microhobbyist/6309-Unleashed-2.0/README.md

# 6309 Unleashed 2.0
 New and upgraded 6309 build - with NITROS-9 in mind!
