microhobbyist/6309-Unleashed-2.0/(list of files, drawings)

Other design files:
Episode3/Logisim/ShadowLockCircuit.circ
