microhobbyist/6309-Unleashed-2.0/Episode5 - CPU card/Episode5 - CPU card.kicad_pcb

## KiCad design Episode5 - CPU card/Episode5 - CPU card.kicad_pcb (2026-03-01)

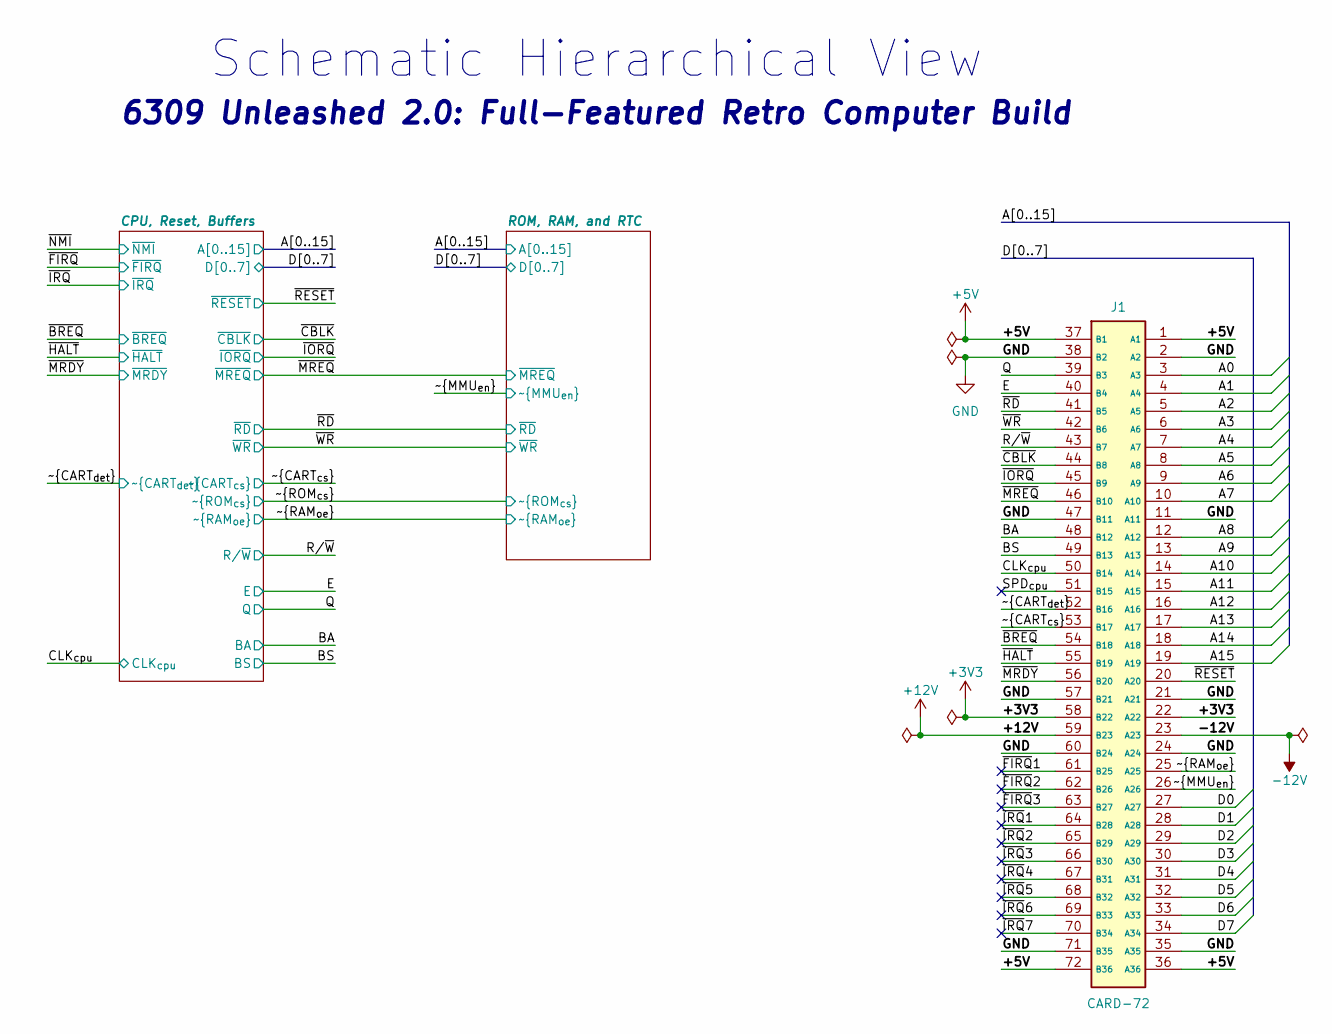
[picture p1: schematic Episode5 - CPU card.kicad_sch, The CPU Card]

Parts:
J1: CARD-72; 72-pin Card Edge PCB; Mouser Part Number 571-5530843-8

Connections:
+3V3: J1.22 (A22), J1.58 (B22)
+5V: J1.1 (A1), J1.36 (A36), J1.37 (B1), J1.72 (B36); also elsewhere on the board
+12V: J1.59 (B23)
-12V: J1.23 (A23)
/A0: J1.3 (A3); also elsewhere on the board
/A1: J1.4 (A4); also elsewhere on the board
/A2: J1.5 (A5); also elsewhere on the board
/A3: J1.6 (A6); also elsewhere on the board
/A4: J1.7 (A7); also elsewhere on the board
/A5: J1.8 (A8); also elsewhere on the board
/A6: J1.9 (A9); also elsewhere on the board
/A7: J1.10 (A10); also elsewhere on the board
/A8: J1.12 (A12); also elsewhere on the board
/A9: J1.13 (A13); also elsewhere on the board
/A10: J1.14 (A14); also elsewhere on the board
/A11: J1.15 (A15); also elsewhere on the board
/A12: J1.16 (A16); also elsewhere on the board
/A13: J1.17 (A17); also elsewhere on the board
/A14: J1.18 (A18); also elsewhere on the board
/A15: J1.19 (A19); also elsewhere on the board
/BA: J1.48 (B12); also elsewhere on the board
/BS: J1.49 (B13); also elsewhere on the board
/CLK_{cpu}: J1.50 (B14); also elsewhere on the board
/D0: J1.27 (A27); also elsewhere on the board
/D1: J1.28 (A28); also elsewhere on the board
/D2: J1.29 (A29); also elsewhere on the board
/D3: J1.30 (A30); also elsewhere on the board
/D4: J1.31 (A31); also elsewhere on the board
/D5: J1.32 (A32); also elsewhere on the board
/D6: J1.33 (A33); also elsewhere on the board
/D7: J1.34 (A34); also elsewhere on the board
/E: J1.40 (B4); also elsewhere on the board
/Q: J1.39 (B3); also elsewhere on the board
/R/~W: J1.43 (B7); also elsewhere on the board
/SPD_{cpu}: J1.51 (B15)
/~BREQ: J1.54 (B18); also elsewhere on the board
/~CART_{cs}: J1.53 (B17); also elsewhere on the board
/~CART_{det}: J1.52 (B16); also elsewhere on the board
/~CBLK: J1.44 (B8); also elsewhere on the board
/~FIRQ1: J1.61 (B25)
/~FIRQ2: J1.62 (B26)
/~FIRQ3: J1.63 (B27)
/~HALT: J1.55 (B19); also elsewhere on the board
/~IORQ: J1.45 (B9); also elsewhere on the board
/~IRQ1: J1.64 (B28)
/~IRQ2: J1.65 (B29)
/~IRQ3: J1.66 (B30)
/~IRQ4: J1.67 (B31)
/~IRQ5: J1.68 (B32)
/~IRQ6: J1.69 (B33)
/~IRQ7: J1.70 (B34)
/~MMU_{en}: J1.26 (A26); also elsewhere on the board
/~MRDY: J1.56 (B20); also elsewhere on the board
/~MREQ: J1.46 (B10); also elsewhere on the board
/~RAM_{oe}: J1.25 (A25); also elsewhere on the board
/~RD: J1.41 (B5); also elsewhere on the board
/~RESET: J1.20 (A20); also elsewhere on the board
/~WR: J1.42 (B6); also elsewhere on the board
GND: J1.2 (A2), J1.11 (A11), J1.21 (A21), J1.24 (A24), J1.35 (A35), J1.38 (B2), J1.47 (B11), J1.57 (B21), J1.60 (B24), J1.71 (B35); also elsewhere on the board

Notes on the sheet:
6309 Unleashed 2.0: Full-Featured Retro Computer Build
Schematic Hierarchical View

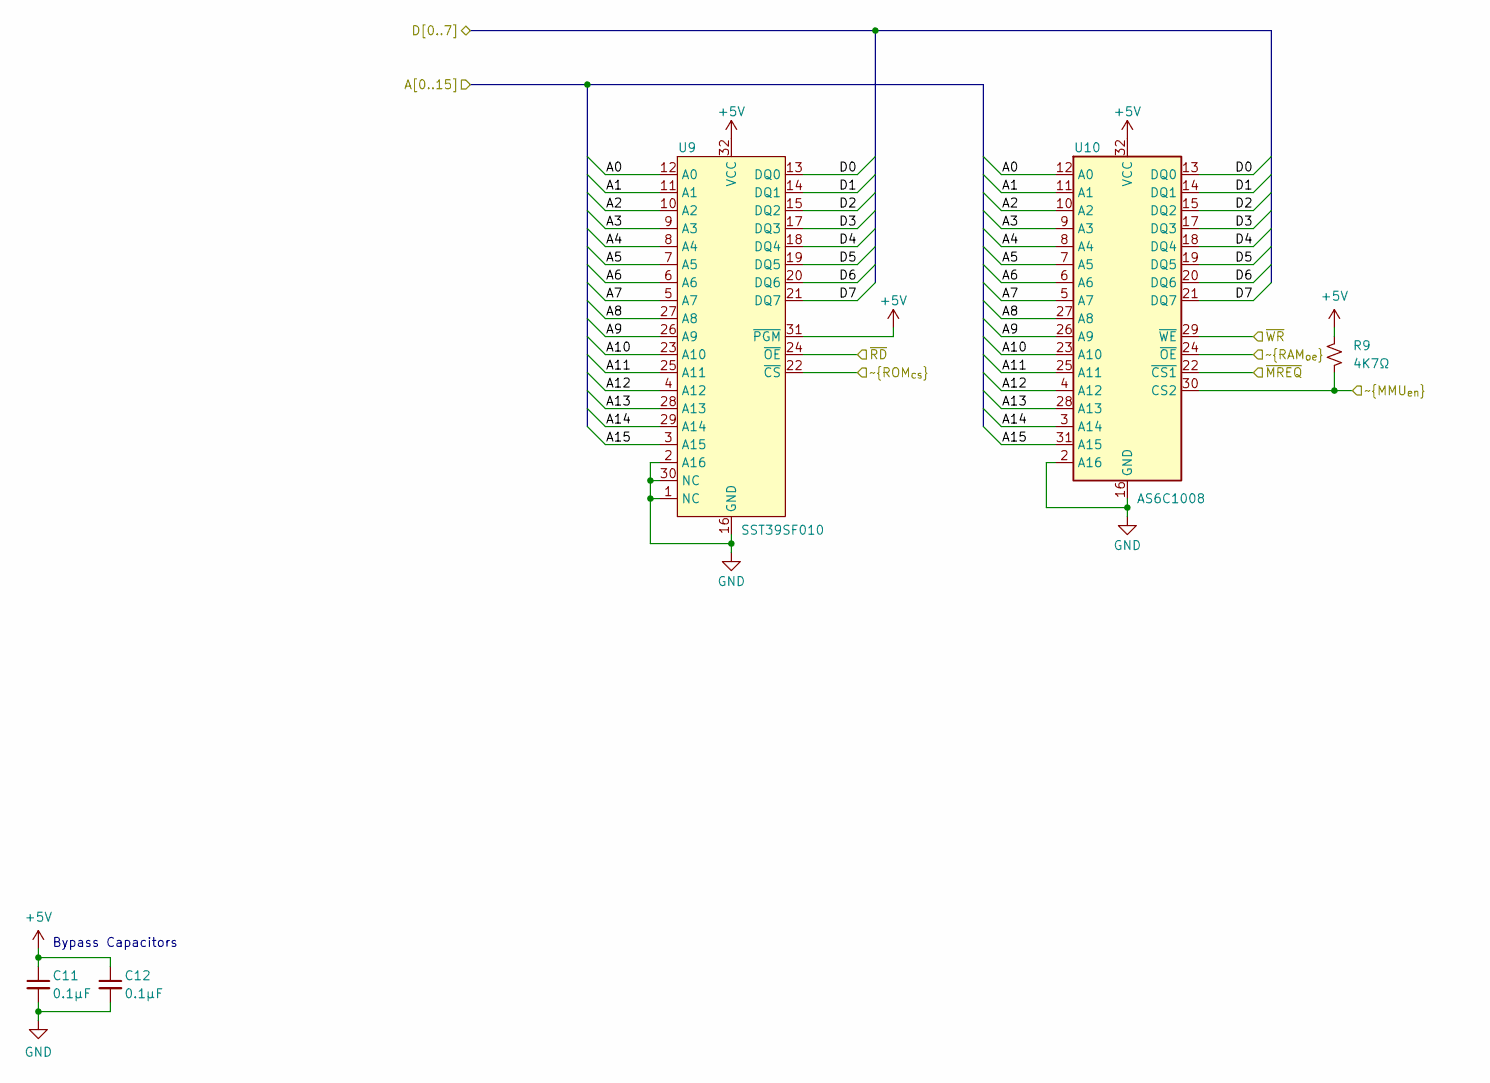
[picture p2: schematic ROMRAM.kicad_sch, Flash ROM, SRAM, and RTC]

Parts:
C11, C12: 0.1µF; C_Disc_D3.0mm_W1.6mm_P2.50mm
R9: 4K7Ω; R_Axial_DIN0207_L6.3mm_D2.5mm_P10.16mm_Horizontal
U9: SST39SF010; DIP_Socket-32_W11.9mm_W12.7mm_W15.24mm_W17.78mm_W18.5mm_3M_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
U10: AS6C1008; DIP-32_W15.24mm_Socket

Connections:
+5V: C11.1, C12.1, R9.2, U9.31 (~PGM), U9.32 (VCC), U10.32 (VCC); also elsewhere on the board
/A0: U9.12 (A0), U10.12 (A0); also elsewhere on the board
/A1: U9.11 (A1), U10.11 (A1); also elsewhere on the board
/A2: U9.10 (A2), U10.10 (A2); also elsewhere on the board
/A3: U9.9 (A3), U10.9 (A3); also elsewhere on the board
/A4: U9.8 (A4), U10.8 (A4); also elsewhere on the board
/A5: U9.7 (A5), U10.7 (A5); also elsewhere on the board
/A6: U9.6 (A6), U10.6 (A6); also elsewhere on the board
/A7: U9.5 (A7), U10.5 (A7); also elsewhere on the board
/A8: U9.27 (A8), U10.27 (A8); also elsewhere on the board
/A9: U9.26 (A9), U10.26 (A9); also elsewhere on the board
/A10: U9.23 (A10), U10.23 (A10); also elsewhere on the board
/A11: U9.25 (A11), U10.25 (A11); also elsewhere on the board
/A12: U9.4 (A12), U10.4 (A12); also elsewhere on the board
/A13: U9.28 (A13), U10.28 (A13); also elsewhere on the board
/A14: U9.29 (A14), U10.3 (A14); also elsewhere on the board
/A15: U9.3 (A15), U10.31 (A15); also elsewhere on the board
/D0: U9.13 (DQ0), U10.13 (DQ0); also elsewhere on the board
/D1: U9.14 (DQ1), U10.14 (DQ1); also elsewhere on the board
/D2: U9.15 (DQ2), U10.15 (DQ2); also elsewhere on the board
/D3: U9.17 (DQ3), U10.17 (DQ3); also elsewhere on the board
/D4: U9.18 (DQ4), U10.18 (DQ4); also elsewhere on the board
/D5: U9.19 (DQ5), U10.19 (DQ5); also elsewhere on the board
/D6: U9.20 (DQ6), U10.20 (DQ6); also elsewhere on the board
/D7: U9.21 (DQ7), U10.21 (DQ7); also elsewhere on the board
/~MMU_{en}: R9.1, U10.30 (CS2); also elsewhere on the board
/~MREQ: U10.22 (~CS1); also elsewhere on the board
/~RAM_{oe}: U10.24 (~OE); also elsewhere on the board
/~RD: U9.24 (~OE); also elsewhere on the board
/~ROM_{cs}: U9.22 (~CS); also elsewhere on the board
/~WR: U10.29 (~WE); also elsewhere on the board
GND: C11.2, C12.2, U9.1 (NC), U9.2 (A16), U9.16 (GND), U9.30 (NC), U10.2 (A16), U10.16 (GND); also elsewhere on the board

Notes on the sheet:
Bypass Capacitors

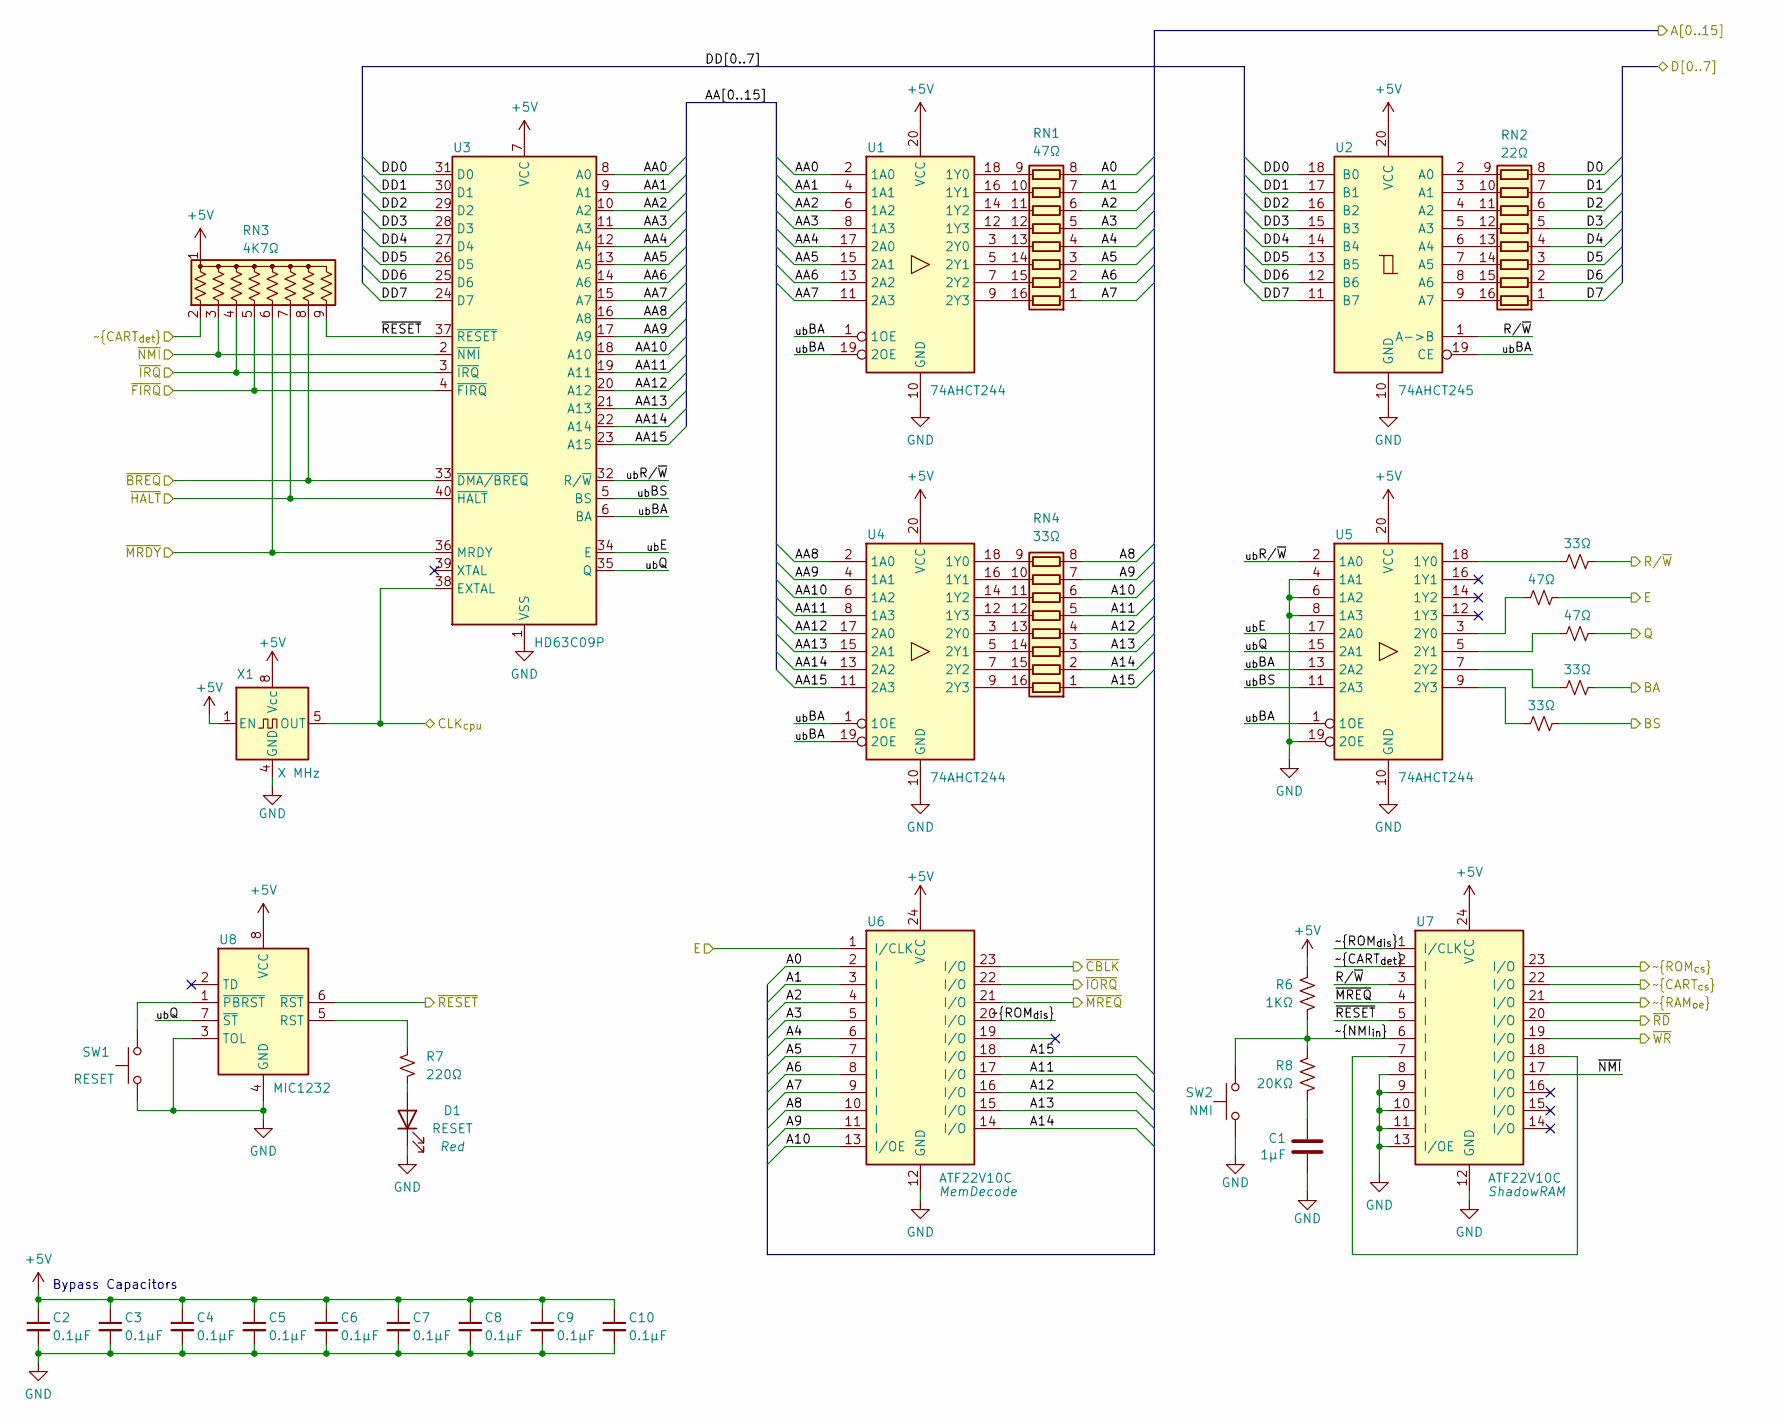
[picture p3: schematic CPU_RESET_BUFFERS.kicad_sch, CPU, Clock, Reset, and Buffers]

Parts:
C1: 1µF; C_Disc_D3.0mm_W1.6mm_P2.50mm
C2, C3, C4, C5, C6, C7, C8, C9, C10: 0.1µF; C_Disc_D3.0mm_W1.6mm_P2.50mm
D1: RESET; LED_D5.0mm
R1, R4, R5: 33Ω; R_Axial_DIN0207_L6.3mm_D2.5mm_P10.16mm_Horizontal
R2, R3: 47Ω; R_Axial_DIN0207_L6.3mm_D2.5mm_P10.16mm_Horizontal
R6: 1KΩ; R_Axial_DIN0207_L6.3mm_D2.5mm_P10.16mm_Horizontal
R7: 220Ω; R_Axial_DIN0207_L6.3mm_D2.5mm_P10.16mm_Horizontal
R8: 20KΩ; R_Axial_DIN0207_L6.3mm_D2.5mm_P10.16mm_Horizontal
RN1: 47Ω; DIP-16_W7.62mm_Socket
RN2: 22Ω; DIP-16_W7.62mm_Socket
RN3: 4K7Ω; R_Array_SIP9
RN4: 33Ω; DIP-16_W7.62mm_Socket
SW1: RESET; SW_Tactile_SKHH_Angled
SW2: NMI; SW_Tactile_SKHH_Angled
U1, U4, U5: 74AHCT244; DIP-20_W7.62mm_Socket
U2: 74AHCT245; DIP-20_W7.62mm_Socket
U3: HD63C09P; DIP-40_W15.24mm_Socket
U6, U7: ATF22V10C; DIP-24_W7.62mm_Socket
U8: MIC1232; DIP-8_W7.62mm_Socket
X1: X MHz; Oscillator_DIP-8

Connections:
+5V: C2.1, C3.1, C4.1, C5.1, C6.1, C7.1, C8.1, C9.1, C10.1, R6.1, RN3.1 (common), U1.20 (VCC), U2.20 (VCC), U3.7 (VCC), U4.20 (VCC), U5.20 (VCC), U6.24 (VCC), U7.24 (VCC), U8.8 (VCC), X1.1 (EN), X1.8 (Vcc); also elsewhere on the board
/A0: RN1.8 (R8.1), U6.2 (I); also elsewhere on the board
/A1: RN1.7 (R7.1), U6.3 (I); also elsewhere on the board
/A2: RN1.6 (R6.1), U6.4 (I); also elsewhere on the board
/A3: RN1.5 (R5.1), U6.5 (I); also elsewhere on the board
/A4: RN1.4 (R4.1), U6.6 (I); also elsewhere on the board
/A5: RN1.3 (R3.1), U6.7 (I); also elsewhere on the board
/A6: RN1.2 (R2.1), U6.8 (I); also elsewhere on the board
/A7: RN1.1 (R1.1), U6.9 (I); also elsewhere on the board
/A8: RN4.8 (R8.1), U6.10 (I); also elsewhere on the board
/A9: RN4.7 (R7.1), U6.11 (I); also elsewhere on the board
/A10: RN4.6 (R6.1), U6.13 (I/OE); also elsewhere on the board
/A11: RN4.5 (R5.1), U6.17 (I/O); also elsewhere on the board
/A12: RN4.4 (R4.1), U6.16 (I/O); also elsewhere on the board
/A13: RN4.3 (R3.1), U6.15 (I/O); also elsewhere on the board
/A14: RN4.2 (R2.1), U6.14 (I/O); also elsewhere on the board
/A15: RN4.1 (R1.1), U6.18 (I/O); also elsewhere on the board
/BA: R4.2; also elsewhere on the board
/BS: R5.2; also elsewhere on the board
/CLK_{cpu}: U3.38 (EXTAL), X1.5 (OUT); also elsewhere on the board
/CPU, Reset, Buffers/AA0: U1.2 (1A0), U3.8 (A0)
/CPU, Reset, Buffers/AA1: U1.4 (1A1), U3.9 (A1)
/CPU, Reset, Buffers/AA2: U1.6 (1A2), U3.10 (A2)
/CPU, Reset, Buffers/AA3: U1.8 (1A3), U3.11 (A3)
/CPU, Reset, Buffers/AA4: U1.17 (2A0), U3.12 (A4)
/CPU, Reset, Buffers/AA5: U1.15 (2A1), U3.13 (A5)
/CPU, Reset, Buffers/AA6: U1.13 (2A2), U3.14 (A6)
/CPU, Reset, Buffers/AA7: U1.11 (2A3), U3.15 (A7)
/CPU, Reset, Buffers/AA8: U3.16 (A8), U4.2 (1A0)
/CPU, Reset, Buffers/AA9: U3.17 (A9), U4.4 (1A1)
/CPU, Reset, Buffers/AA10: U3.18 (A10), U4.6 (1A2)
/CPU, Reset, Buffers/AA11: U3.19 (A11), U4.8 (1A3)
/CPU, Reset, Buffers/AA12: U3.20 (A12), U4.17 (2A0)
/CPU, Reset, Buffers/AA13: U3.21 (A13), U4.15 (2A1)
/CPU, Reset, Buffers/AA14: U3.22 (A14), U4.13 (2A2)
/CPU, Reset, Buffers/AA15: U3.23 (A15), U4.11 (2A3)
/CPU, Reset, Buffers/DD0: U2.18 (B0), U3.31 (D0)
/CPU, Reset, Buffers/DD1: U2.17 (B1), U3.30 (D1)
/CPU, Reset, Buffers/DD2: U2.16 (B2), U3.29 (D2)
/CPU, Reset, Buffers/DD3: U2.15 (B3), U3.28 (D3)
/CPU, Reset, Buffers/DD4: U2.14 (B4), U3.27 (D4)
/CPU, Reset, Buffers/DD5: U2.13 (B5), U3.26 (D5)
/CPU, Reset, Buffers/DD6: U2.12 (B6), U3.25 (D6)
/CPU, Reset, Buffers/DD7: U2.11 (B7), U3.24 (D7)
/CPU, Reset, Buffers/_{ub}BA: U1.1 (1OE), U1.19 (2OE), U2.19 (CE), U3.6 (BA), U4.1 (1OE), U4.19 (2OE), U5.1 (1OE), U5.13 (2A2)
/CPU, Reset, Buffers/_{ub}BS: U3.5 (BS), U5.11 (2A3)
/CPU, Reset, Buffers/_{ub}E: U3.34 (E), U5.17 (2A0)
/CPU, Reset, Buffers/_{ub}Q: U3.35 (Q), U5.15 (2A1), U8.7 (~ST)
/CPU, Reset, Buffers/_{ub}R/~W: U3.32 (R/~W), U5.2 (1A0)
/CPU, Reset, Buffers/~NMI_{in}: R6.2, R8.1, SW2.2, U7.6 (I)
/CPU, Reset, Buffers/~ROM_{dis}: U6.20 (I/O), U7.1 (I/CLK)
/D0: RN2.8 (R8.1); also elsewhere on the board
/D1: RN2.7 (R7.1); also elsewhere on the board
/D2: RN2.6 (R6.1); also elsewhere on the board
/D3: RN2.5 (R5.1); also elsewhere on the board
/D4: RN2.4 (R4.1); also elsewhere on the board
/D5: RN2.3 (R3.1); also elsewhere on the board
/D6: RN2.2 (R2.1); also elsewhere on the board
/D7: RN2.1 (R1.1); also elsewhere on the board
/E: R2.2, U6.1 (I/CLK); also elsewhere on the board
/Q: R3.2; also elsewhere on the board
/R/~W: R1.2, U2.1 (A->B), U7.3 (I); also elsewhere on the board
/~BREQ: RN3.8 (R7), U3.33 (~DMA/BREQ); also elsewhere on the board
/~CART_{cs}: U7.22 (I/O); also elsewhere on the board
/~CART_{det}: RN3.2 (R1), U7.2 (I); also elsewhere on the board
/~CBLK: U6.23 (I/O); also elsewhere on the board
/~FIRQ: RN3.5 (R4), U3.4 (~FIRQ)
/~HALT: RN3.7 (R6), U3.40 (~HALT); also elsewhere on the board
/~IORQ: U6.22 (I/O); also elsewhere on the board
/~IRQ: RN3.4 (R3), U3.3 (~IRQ)
/~MRDY: RN3.6 (R5), U3.36 (MRDY); also elsewhere on the board
/~MREQ: U6.21 (I/O), U7.4 (I); also elsewhere on the board
/~NMI: RN3.3 (R2), U3.2 (~NMI), U7.17 (I/O)
/~RAM_{oe}: U7.21 (I/O); also elsewhere on the board
/~RD: U7.20 (I/O); also elsewhere on the board
/~RESET: RN3.9 (R8), U3.37 (~RESET), U7.5 (I), U8.6 (~RST); also elsewhere on the board
/~ROM_{cs}: U7.23 (I/O); also elsewhere on the board
/~WR: U7.19 (I/O); also elsewhere on the board
GND: C1.2, C2.2, C3.2, C4.2, C5.2, C6.2, C7.2, C8.2, C9.2, C10.2, D1.1 (K), SW1.1, SW2.1, U1.10 (GND), U2.10 (GND), U3.1 (VSS), U4.10 (GND), U5.4 (1A1), U5.6 (1A2), U5.8 (1A3), U5.10 (GND), U5.19 (2OE), U6.12 (GND), U7.8 (I), U7.9 (I), U7.10 (I), U7.11 (I), U7.12 (GND), U7.13 (I/OE), U8.3 (TOL), U8.4 (GND), X1.4 (GND); also elsewhere on the board
unnamed: C1.1, R8.2
unnamed: D1.2 (A), R7.1
unnamed: RN1.16 (R1.2), U1.9 (2Y3)
unnamed: RN1.15 (R2.2), U1.7 (2Y2)
unnamed: RN1.14 (R3.2), U1.5 (2Y1)
unnamed: RN1.13 (R4.2), U1.3 (2Y0)
unnamed: RN1.12 (R5.2), U1.12 (1Y3)
unnamed: RN1.11 (R6.2), U1.14 (1Y2)
unnamed: RN1.10 (R7.2), U1.16 (1Y1)
unnamed: RN1.9 (R8.2), U1.18 (1Y0)
unnamed: RN2.16 (R1.2), U2.9 (A7)
unnamed: RN2.15 (R2.2), U2.8 (A6)
unnamed: RN2.14 (R3.2), U2.7 (A5)
unnamed: RN2.13 (R4.2), U2.6 (A4)
unnamed: RN2.12 (R5.2), U2.5 (A3)
unnamed: RN2.11 (R6.2), U2.4 (A2)
unnamed: RN2.10 (R7.2), U2.3 (A1)
unnamed: RN2.9 (R8.2), U2.2 (A0)
unnamed: RN4.16 (R1.2), U4.9 (2Y3)
unnamed: RN4.15 (R2.2), U4.7 (2Y2)
unnamed: RN4.14 (R3.2), U4.5 (2Y1)
unnamed: RN4.13 (R4.2), U4.3 (2Y0)
unnamed: RN4.12 (R5.2), U4.12 (1Y3)
unnamed: RN4.11 (R6.2), U4.14 (1Y2)
unnamed: RN4.10 (R7.2), U4.16 (1Y1)
unnamed: RN4.9 (R8.2), U4.18 (1Y0)
unnamed: R1.1, U5.18 (1Y0)
unnamed: R2.1, U5.3 (2Y0)
unnamed: R3.1, U5.5 (2Y1)
unnamed: R4.1, U5.7 (2Y2)
unnamed: R5.1, U5.9 (2Y3)
unnamed: U7.7 (I), U7.18 (I/O)
unnamed: R7.2, U8.5 (RST)
unnamed: SW1.2, U8.1 (~PBRST)

Notes on the sheet:
Bypass Capacitors

Board: 2 copper layers, 40 parts (0 on the bottom side), 115 nets, no tracks yet.
