microhobbyist/6309-Unleashed-2.0/Episode4/Episode4.kicad_pcb

## KiCad design Episode4/Episode4.kicad_pcb (2026-02-20)

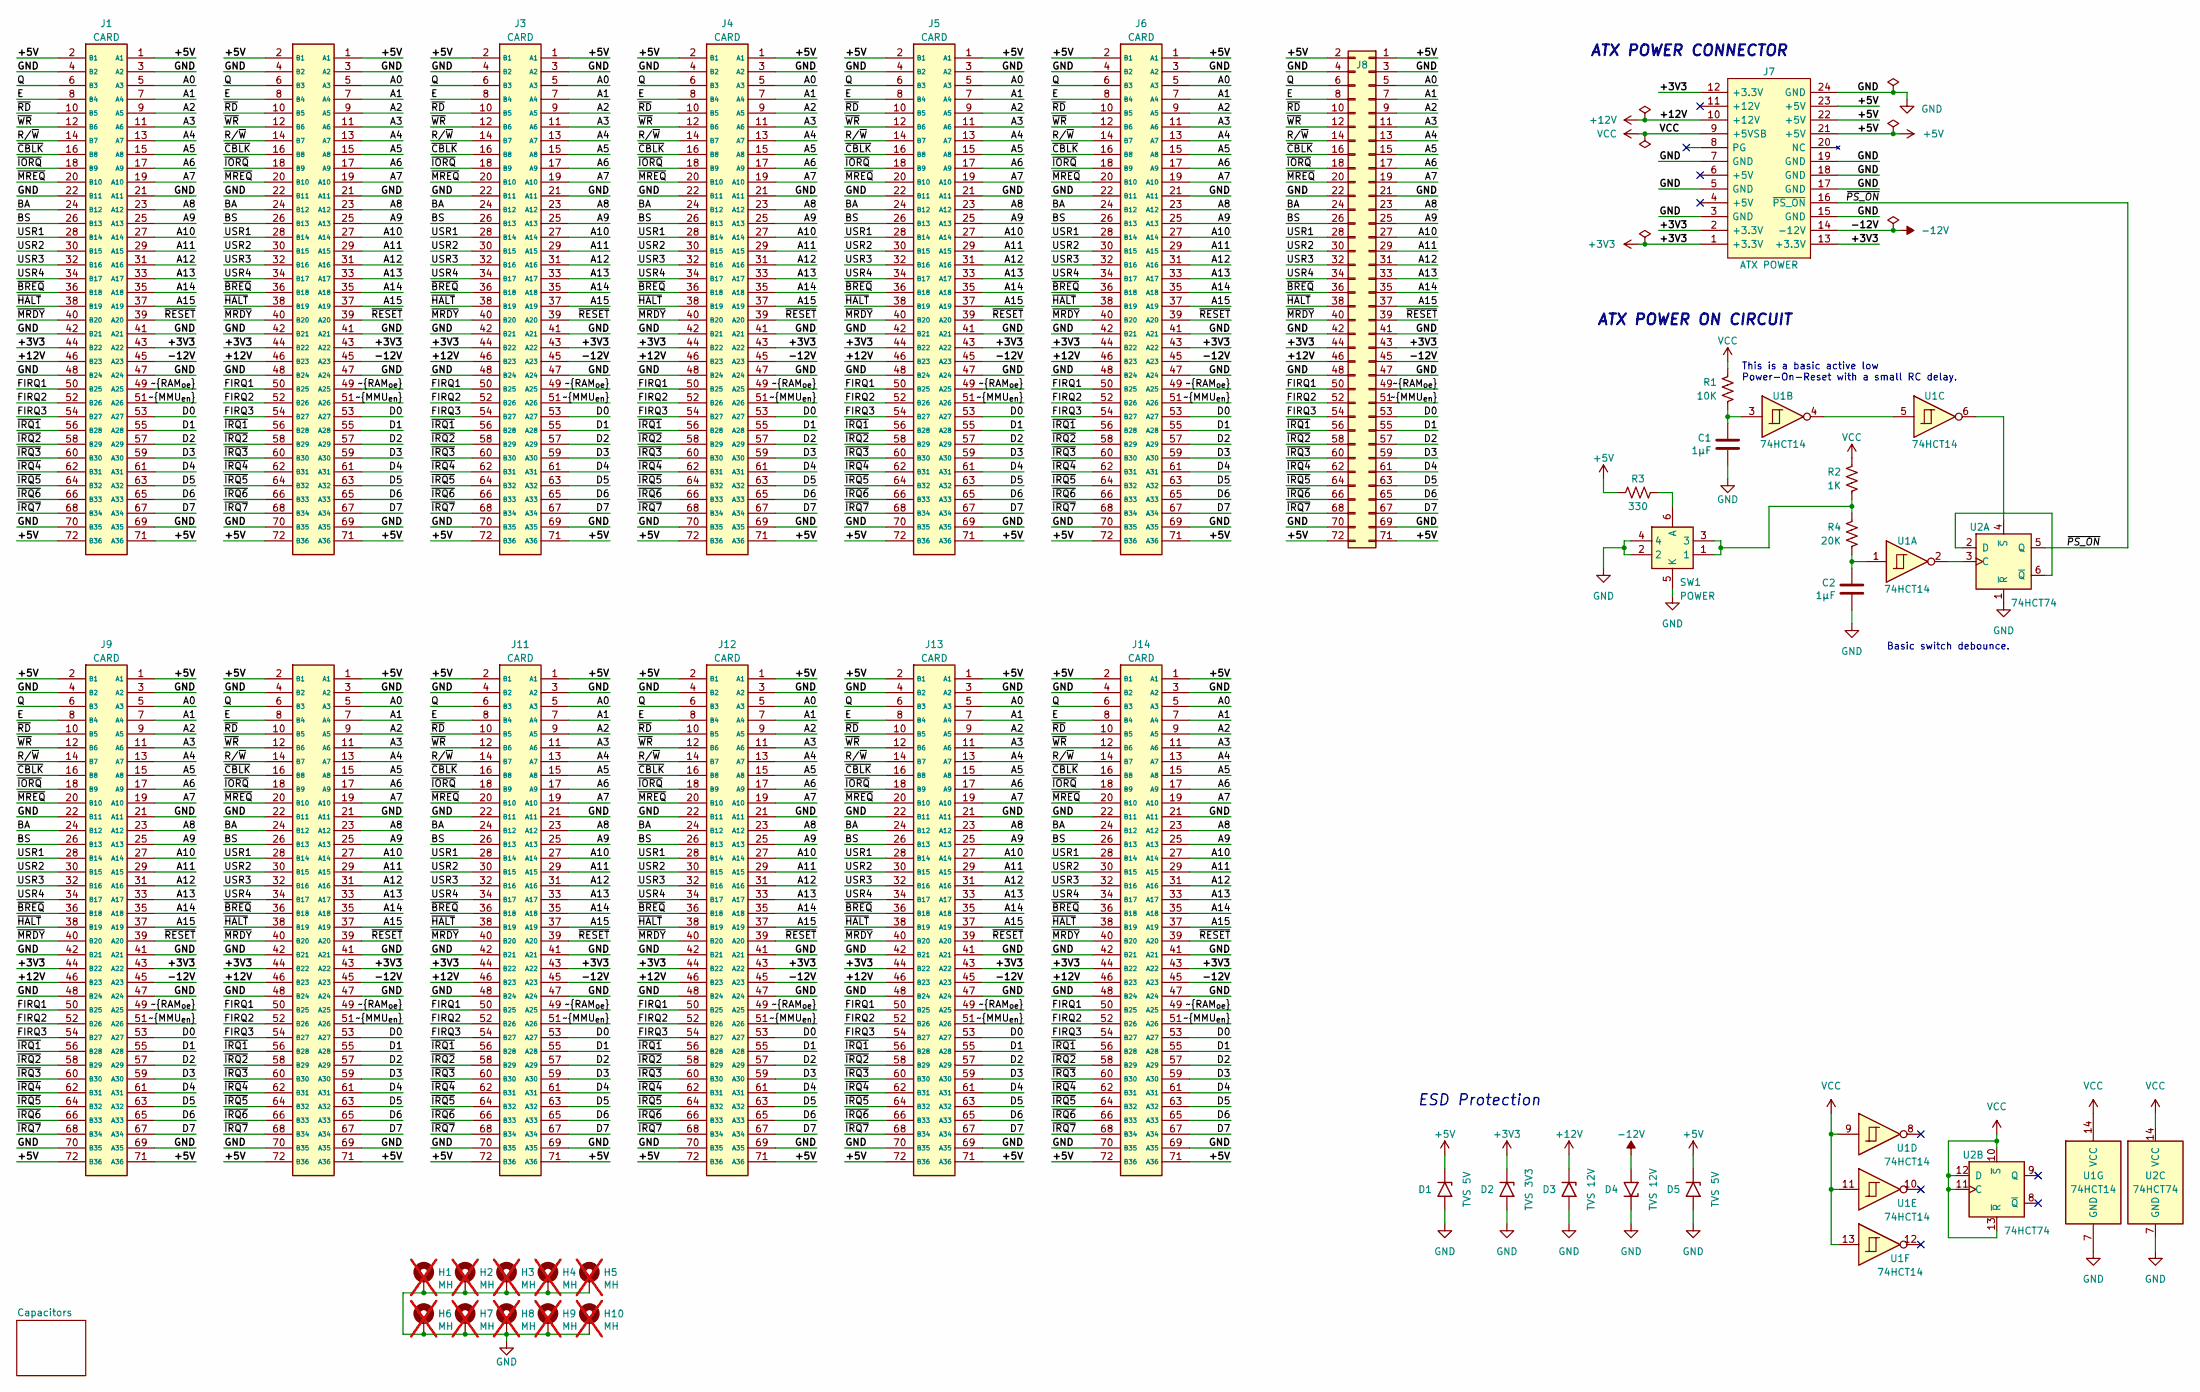
[picture p4: schematic Episode4.kicad_sch, 8-bit ISA style ATX backblane]

Parts:
C1, C2: 1µF; C_0805_2012Metric_Pad1.18x1.45mm_HandSolder; Manufacturer_Part_Number CL21B105KBFNNNG
D1, D5: TVS 5V; D_SMB; Manufacturer_Part_Number SMBJ5.0A-E3/5B
D2: TVS 3V3; D_SMB; Manufacturer_Part_Number SMBJ3V3-E3/5B
D3, D4: TVS 12V; D_SMB; Manufacturer_Part_Number SMBJ12A-E3/5B
H1, H2, H3, H4, H5, H6, H7, H8, H9, H10: MH; MountingHole_3.5mm_Pad_Via; not fitted
J1, J2, J3, J4, J5, J6, J9, J10, J11, J12, J13, J14: CARD; 72-pin CE connector; Mouser Part Number 571-5530843-8
J7: ATX POWER; ATX_PSU_CONN; Mouser Part Number 571-1-1775099-3
J8: BB Con; PinSocket_2x36_P2.54mm_Vertical; Manufacturer_Part_Number 929852-01-36-RA
R1: 10K; R_0805_2012Metric_Pad1.20x1.40mm_HandSolder; Manufacturer_Part_Number CR0805-FX-1002ELF
R2: 1K; R_0805_2012Metric_Pad1.20x1.40mm_HandSolder; Manufacturer_Part_Number CR0805-FX-1001ELF
R3: 330; R_0805_2012Metric_Pad1.20x1.40mm_HandSolder; Manufacturer_Part_Number CR0805-FX-3300ELF
R4: 20K; R_0805_2012Metric_Pad1.20x1.40mm_HandSolder; Manufacturer_Part_Number CR0805-FX-2002ELF
SW1: POWER; TS2912121G300D; Manufacturer_Part_Number TS29-1212-1-G-300-D; Mouser Part Number 179-TS2912121G300D
U1: 74HCT14; SOIC-14_3.9x8.7mm_P1.27mm; Manufacturer_Part_Number CD74HCT14M96
U2: 74HCT74; SOIC-14_3.9x8.7mm_P1.27mm; Manufacturer_Part_Number CD74HCT74M96

Connections:
+3V3: D2.1 (A1), J1.43 (A22), J1.44 (B22), J2.43 (A22), J2.44 (B22), J3.43 (A22), J3.44 (B22), J4.43 (A22), J4.44 (B22), J5.43 (A22), J5.44 (B22), J6.43 (A22), J6.44 (B22), J7.1 (+3.3V), J7.2 (+3.3V), J7.12 (+3.3V), J7.13 (+3.3V), J8.43, J8.44, J9.43 (A22), J9.44 (B22), J10.43 (A22), J10.44 (B22), J11.43 (A22), J11.44 (B22), J12.43 (A22), J12.44 (B22), J13.43 (A22), J13.44 (B22), J14.43 (A22), J14.44 (B22); also elsewhere on the board
+5V: D1.1 (A1), D5.1 (A1), J1.1 (A1), J1.2 (B1), J1.71 (A36), J1.72 (B36), J2.1 (A1), J2.2 (B1), J2.71 (A36), J2.72 (B36), J3.1 (A1), J3.2 (B1), J3.71 (A36), J3.72 (B36), J4.1 (A1), J4.2 (B1), J4.71 (A36), J4.72 (B36), J5.1 (A1), J5.2 (B1), J5.71 (A36), J5.72 (B36), J6.1 (A1), J6.2 (B1), J6.71 (A36), J6.72 (B36), J7.21 (+5V), J7.22 (+5V), J7.23 (+5V), J8.1, J8.2, J8.71, J8.72, J9.1 (A1), J9.2 (B1), J9.71 (A36), J9.72 (B36), J10.1 (A1), J10.2 (B1), J10.71 (A36), J10.72 (B36), J11.1 (A1), J11.2 (B1), J11.71 (A36), J11.72 (B36), J12.1 (A1), J12.2 (B1), J12.71 (A36), J12.72 (B36), J13.1 (A1), J13.2 (B1), J13.71 (A36), J13.72 (B36), J14.1 (A1), J14.2 (B1), J14.71 (A36), J14.72 (B36), R3.2; also elsewhere on the board
+12V: D3.1 (A1), J1.46 (B23), J2.46 (B23), J3.46 (B23), J4.46 (B23), J5.46 (B23), J6.46 (B23), J7.10 (+12V), J8.46, J9.46 (B23), J10.46 (B23), J11.46 (B23), J12.46 (B23), J13.46 (B23), J14.46 (B23); also elsewhere on the board
-12V: D4.2 (A2), J1.45 (A23), J2.45 (A23), J3.45 (A23), J4.45 (A23), J5.45 (A23), J6.45 (A23), J7.14 (-12V), J8.45, J9.45 (A23), J10.45 (A23), J11.45 (A23), J12.45 (A23), J13.45 (A23), J14.45 (A23); also elsewhere on the board
/A0: J1.5 (A3), J2.5 (A3), J3.5 (A3), J4.5 (A3), J5.5 (A3), J6.5 (A3), J8.5, J9.5 (A3), J10.5 (A3), J11.5 (A3), J12.5 (A3), J13.5 (A3), J14.5 (A3)
/A1: J1.7 (A4), J2.7 (A4), J3.7 (A4), J4.7 (A4), J5.7 (A4), J6.7 (A4), J8.7, J9.7 (A4), J10.7 (A4), J11.7 (A4), J12.7 (A4), J13.7 (A4), J14.7 (A4)
/A2: J1.9 (A5), J2.9 (A5), J3.9 (A5), J4.9 (A5), J5.9 (A5), J6.9 (A5), J8.9, J9.9 (A5), J10.9 (A5), J11.9 (A5), J12.9 (A5), J13.9 (A5), J14.9 (A5)
/A3: J1.11 (A6), J2.11 (A6), J3.11 (A6), J4.11 (A6), J5.11 (A6), J6.11 (A6), J8.11, J9.11 (A6), J10.11 (A6), J11.11 (A6), J12.11 (A6), J13.11 (A6), J14.11 (A6)
/A4: J1.13 (A7), J2.13 (A7), J3.13 (A7), J4.13 (A7), J5.13 (A7), J6.13 (A7), J8.13, J9.13 (A7), J10.13 (A7), J11.13 (A7), J12.13 (A7), J13.13 (A7), J14.13 (A7)
/A5: J1.15 (A8), J2.15 (A8), J3.15 (A8), J4.15 (A8), J5.15 (A8), J6.15 (A8), J8.15, J9.15 (A8), J10.15 (A8), J11.15 (A8), J12.15 (A8), J13.15 (A8), J14.15 (A8)
/A6: J1.17 (A9), J2.17 (A9), J3.17 (A9), J4.17 (A9), J5.17 (A9), J6.17 (A9), J8.17, J9.17 (A9), J10.17 (A9), J11.17 (A9), J12.17 (A9), J13.17 (A9), J14.17 (A9)
/A7: J1.19 (A10), J2.19 (A10), J3.19 (A10), J4.19 (A10), J5.19 (A10), J6.19 (A10), J8.19, J9.19 (A10), J10.19 (A10), J11.19 (A10), J12.19 (A10), J13.19 (A10), J14.19 (A10)
/A8: J1.23 (A12), J2.23 (A12), J3.23 (A12), J4.23 (A12), J5.23 (A12), J6.23 (A12), J8.23, J9.23 (A12), J10.23 (A12), J11.23 (A12), J12.23 (A12), J13.23 (A12), J14.23 (A12)
/A9: J1.25 (A13), J2.25 (A13), J3.25 (A13), J4.25 (A13), J5.25 (A13), J6.25 (A13), J8.25, J9.25 (A13), J10.25 (A13), J11.25 (A13), J12.25 (A13), J13.25 (A13), J14.25 (A13)
/A10: J1.27 (A14), J2.27 (A14), J3.27 (A14), J4.27 (A14), J5.27 (A14), J6.27 (A14), J8.27, J9.27 (A14), J10.27 (A14), J11.27 (A14), J12.27 (A14), J13.27 (A14), J14.27 (A14)
/A11: J1.29 (A15), J2.29 (A15), J3.29 (A15), J4.29 (A15), J5.29 (A15), J6.29 (A15), J8.29, J9.29 (A15), J10.29 (A15), J11.29 (A15), J12.29 (A15), J13.29 (A15), J14.29 (A15)
/A12: J1.31 (A16), J2.31 (A16), J3.31 (A16), J4.31 (A16), J5.31 (A16), J6.31 (A16), J8.31, J9.31 (A16), J10.31 (A16), J11.31 (A16), J12.31 (A16), J13.31 (A16), J14.31 (A16)
/A13: J1.33 (A17), J2.33 (A17), J3.33 (A17), J4.33 (A17), J5.33 (A17), J6.33 (A17), J8.33, J9.33 (A17), J10.33 (A17), J11.33 (A17), J12.33 (A17), J13.33 (A17), J14.33 (A17)
/A14: J1.35 (A18), J2.35 (A18), J3.35 (A18), J4.35 (A18), J5.35 (A18), J6.35 (A18), J8.35, J9.35 (A18), J10.35 (A18), J11.35 (A18), J12.35 (A18), J13.35 (A18), J14.35 (A18)
/A15: J1.37 (A19), J2.37 (A19), J3.37 (A19), J4.37 (A19), J5.37 (A19), J6.37 (A19), J8.37, J9.37 (A19), J10.37 (A19), J11.37 (A19), J12.37 (A19), J13.37 (A19), J14.37 (A19)
/BA: J1.24 (B12), J2.24 (B12), J3.24 (B12), J4.24 (B12), J5.24 (B12), J6.24 (B12), J8.24, J9.24 (B12), J10.24 (B12), J11.24 (B12), J12.24 (B12), J13.24 (B12), J14.24 (B12)
/BS: J1.26 (B13), J2.26 (B13), J3.26 (B13), J4.26 (B13), J5.26 (B13), J6.26 (B13), J8.26, J9.26 (B13), J10.26 (B13), J11.26 (B13), J12.26 (B13), J13.26 (B13), J14.26 (B13)
/D0: J1.53 (A27), J2.53 (A27), J3.53 (A27), J4.53 (A27), J5.53 (A27), J6.53 (A27), J8.53, J9.53 (A27), J10.53 (A27), J11.53 (A27), J12.53 (A27), J13.53 (A27), J14.53 (A27)
/D1: J1.55 (A28), J2.55 (A28), J3.55 (A28), J4.55 (A28), J5.55 (A28), J6.55 (A28), J8.55, J9.55 (A28), J10.55 (A28), J11.55 (A28), J12.55 (A28), J13.55 (A28), J14.55 (A28)
/D2: J1.57 (A29), J2.57 (A29), J3.57 (A29), J4.57 (A29), J5.57 (A29), J6.57 (A29), J8.57, J9.57 (A29), J10.57 (A29), J11.57 (A29), J12.57 (A29), J13.57 (A29), J14.57 (A29)
/D3: J1.59 (A30), J2.59 (A30), J3.59 (A30), J4.59 (A30), J5.59 (A30), J6.59 (A30), J8.59, J9.59 (A30), J10.59 (A30), J11.59 (A30), J12.59 (A30), J13.59 (A30), J14.59 (A30)
/D4: J1.61 (A31), J2.61 (A31), J3.61 (A31), J4.61 (A31), J5.61 (A31), J6.61 (A31), J8.61, J9.61 (A31), J10.61 (A31), J11.61 (A31), J12.61 (A31), J13.61 (A31), J14.61 (A31)
/D5: J1.63 (A32), J2.63 (A32), J3.63 (A32), J4.63 (A32), J5.63 (A32), J6.63 (A32), J8.63, J9.63 (A32), J10.63 (A32), J11.63 (A32), J12.63 (A32), J13.63 (A32), J14.63 (A32)
/D6: J1.65 (A33), J2.65 (A33), J3.65 (A33), J4.65 (A33), J5.65 (A33), J6.65 (A33), J8.65, J9.65 (A33), J10.65 (A33), J11.65 (A33), J12.65 (A33), J13.65 (A33), J14.65 (A33)
/D7: J1.67 (A34), J2.67 (A34), J3.67 (A34), J4.67 (A34), J5.67 (A34), J6.67 (A34), J8.67, J9.67 (A34), J10.67 (A34), J11.67 (A34), J12.67 (A34), J13.67 (A34), J14.67 (A34)
/E: J1.8 (B4), J2.8 (B4), J3.8 (B4), J4.8 (B4), J5.8 (B4), J6.8 (B4), J8.8, J9.8 (B4), J10.8 (B4), J11.8 (B4), J12.8 (B4), J13.8 (B4), J14.8 (B4)
/FIRQ1: J1.50 (B25), J2.50 (B25), J3.50 (B25), J4.50 (B25), J5.50 (B25), J6.50 (B25), J8.50, J9.50 (B25), J10.50 (B25), J11.50 (B25), J12.50 (B25), J13.50 (B25), J14.50 (B25)
/FIRQ2: J1.52 (B26), J2.52 (B26), J3.52 (B26), J4.52 (B26), J5.52 (B26), J6.52 (B26), J8.52, J9.52 (B26), J10.52 (B26), J11.52 (B26), J12.52 (B26), J13.52 (B26), J14.52 (B26)
/FIRQ3: J1.54 (B27), J2.54 (B27), J3.54 (B27), J4.54 (B27), J5.54 (B27), J6.54 (B27), J8.54, J9.54 (B27), J10.54 (B27), J11.54 (B27), J12.54 (B27), J13.54 (B27), J14.54 (B27)
/Q: J1.6 (B3), J2.6 (B3), J3.6 (B3), J4.6 (B3), J5.6 (B3), J6.6 (B3), J8.6, J9.6 (B3), J10.6 (B3), J11.6 (B3), J12.6 (B3), J13.6 (B3), J14.6 (B3)
/R/~W: J1.14 (B7), J2.14 (B7), J3.14 (B7), J4.14 (B7), J5.14 (B7), J6.14 (B7), J8.14, J9.14 (B7), J10.14 (B7), J11.14 (B7), J12.14 (B7), J13.14 (B7), J14.14 (B7)
/USR1: J1.28 (B14), J2.28 (B14), J3.28 (B14), J4.28 (B14), J5.28 (B14), J6.28 (B14), J8.28, J9.28 (B14), J10.28 (B14), J11.28 (B14), J12.28 (B14), J13.28 (B14), J14.28 (B14)
/USR2: J1.30 (B15), J2.30 (B15), J3.30 (B15), J4.30 (B15), J5.30 (B15), J6.30 (B15), J8.30, J9.30 (B15), J10.30 (B15), J11.30 (B15), J12.30 (B15), J13.30 (B15), J14.30 (B15)
/USR3: J1.32 (B16), J2.32 (B16), J3.32 (B16), J4.32 (B16), J5.32 (B16), J6.32 (B16), J8.32, J9.32 (B16), J10.32 (B16), J11.32 (B16), J12.32 (B16), J13.32 (B16), J14.32 (B16)
/USR4: J1.34 (B17), J2.34 (B17), J3.34 (B17), J4.34 (B17), J5.34 (B17), J6.34 (B17), J8.34, J9.34 (B17), J10.34 (B17), J11.34 (B17), J12.34 (B17), J13.34 (B17), J14.34 (B17)
/~BREQ: J1.36 (B18), J2.36 (B18), J3.36 (B18), J4.36 (B18), J5.36 (B18), J6.36 (B18), J8.36, J9.36 (B18), J10.36 (B18), J11.36 (B18), J12.36 (B18), J13.36 (B18), J14.36 (B18)
/~CBLK: J1.16 (B8), J2.16 (B8), J3.16 (B8), J4.16 (B8), J5.16 (B8), J6.16 (B8), J8.16, J9.16 (B8), J10.16 (B8), J11.16 (B8), J12.16 (B8), J13.16 (B8), J14.16 (B8)
/~HALT: J1.38 (B19), J2.38 (B19), J3.38 (B19), J4.38 (B19), J5.38 (B19), J6.38 (B19), J8.38, J9.38 (B19), J10.38 (B19), J11.38 (B19), J12.38 (B19), J13.38 (B19), J14.38 (B19)
/~IORQ: J1.18 (B9), J2.18 (B9), J3.18 (B9), J4.18 (B9), J5.18 (B9), J6.18 (B9), J8.18, J9.18 (B9), J10.18 (B9), J11.18 (B9), J12.18 (B9), J13.18 (B9), J14.18 (B9)
/~IRQ1: J1.56 (B28), J2.56 (B28), J3.56 (B28), J4.56 (B28), J5.56 (B28), J6.56 (B28), J8.56, J9.56 (B28), J10.56 (B28), J11.56 (B28), J12.56 (B28), J13.56 (B28), J14.56 (B28)
/~IRQ2: J1.58 (B29), J2.58 (B29), J3.58 (B29), J4.58 (B29), J5.58 (B29), J6.58 (B29), J8.58, J9.58 (B29), J10.58 (B29), J11.58 (B29), J12.58 (B29), J13.58 (B29), J14.58 (B29)
/~IRQ3: J1.60 (B30), J2.60 (B30), J3.60 (B30), J4.60 (B30), J5.60 (B30), J6.60 (B30), J8.60, J9.60 (B30), J10.60 (B30), J11.60 (B30), J12.60 (B30), J13.60 (B30), J14.60 (B30)
/~IRQ4: J1.62 (B31), J2.62 (B31), J3.62 (B31), J4.62 (B31), J5.62 (B31), J6.62 (B31), J8.62, J9.62 (B31), J10.62 (B31), J11.62 (B31), J12.62 (B31), J13.62 (B31), J14.62 (B31)
/~IRQ5: J1.64 (B32), J2.64 (B32), J3.64 (B32), J4.64 (B32), J5.64 (B32), J6.64 (B32), J8.64, J9.64 (B32), J10.64 (B32), J11.64 (B32), J12.64 (B32), J13.64 (B32), J14.64 (B32)
/~IRQ6: J1.66 (B33), J2.66 (B33), J3.66 (B33), J4.66 (B33), J5.66 (B33), J6.66 (B33), J8.66, J9.66 (B33), J10.66 (B33), J11.66 (B33), J12.66 (B33), J13.66 (B33), J14.66 (B33)
/~IRQ7: J1.68 (B34), J2.68 (B34), J3.68 (B34), J4.68 (B34), J5.68 (B34), J6.68 (B34), J8.68, J9.68 (B34), J10.68 (B34), J11.68 (B34), J12.68 (B34), J13.68 (B34), J14.68 (B34)
/~MMU_{en}: J1.51 (A26), J2.51 (A26), J3.51 (A26), J4.51 (A26), J5.51 (A26), J6.51 (A26), J8.51, J9.51 (A26), J10.51 (A26), J11.51 (A26), J12.51 (A26), J13.51 (A26), J14.51 (A26)
/~MRDY: J1.40 (B20), J2.40 (B20), J3.40 (B20), J4.40 (B20), J5.40 (B20), J6.40 (B20), J8.40, J9.40 (B20), J10.40 (B20), J11.40 (B20), J12.40 (B20), J13.40 (B20), J14.40 (B20)
/~MREQ: J1.20 (B10), J2.20 (B10), J3.20 (B10), J4.20 (B10), J5.20 (B10), J6.20 (B10), J8.20, J9.20 (B10), J10.20 (B10), J11.20 (B10), J12.20 (B10), J13.20 (B10), J14.20 (B10)
/~PS_ON: J7.16 (~PS_ON), U2.5 (Q)
/~RAM_{oe}: J1.49 (A25), J2.49 (A25), J3.49 (A25), J4.49 (A25), J5.49 (A25), J6.49 (A25), J8.49, J9.49 (A25), J10.49 (A25), J11.49 (A25), J12.49 (A25), J13.49 (A25), J14.49 (A25)
/~RD: J1.10 (B5), J2.10 (B5), J3.10 (B5), J4.10 (B5), J5.10 (B5), J6.10 (B5), J8.10, J9.10 (B5), J10.10 (B5), J11.10 (B5), J12.10 (B5), J13.10 (B5), J14.10 (B5)
/~RESET: J1.39 (A20), J2.39 (A20), J3.39 (A20), J4.39 (A20), J5.39 (A20), J6.39 (A20), J8.39, J9.39 (A20), J10.39 (A20), J11.39 (A20), J12.39 (A20), J13.39 (A20), J14.39 (A20)
/~WR: J1.12 (B6), J2.12 (B6), J3.12 (B6), J4.12 (B6), J5.12 (B6), J6.12 (B6), J8.12, J9.12 (B6), J10.12 (B6), J11.12 (B6), J12.12 (B6), J13.12 (B6), J14.12 (B6)
GND: C1.2, C2.2, D1.2 (A2), D2.2 (A2), D3.2 (A2), D4.1 (A1), D5.2 (A2), H1.1, H2.1, H3.1, H4.1, H5.1, H6.1, H7.1, H8.1, H9.1, H10.1, J1.3 (A2), J1.4 (B2), J1.21 (A11), J1.22 (B11), J1.41 (A21), J1.42 (B21), J1.47 (A24), J1.48 (B24), J1.69 (A35), J1.70 (B35), J2.3 (A2), J2.4 (B2), J2.21 (A11), J2.22 (B11), J2.41 (A21), J2.42 (B21), J2.47 (A24), J2.48 (B24), J2.69 (A35), J2.70 (B35), J3.3 (A2), J3.4 (B2), J3.21 (A11), J3.22 (B11), J3.41 (A21), J3.42 (B21), J3.47 (A24), J3.48 (B24), J3.69 (A35), J3.70 (B35), J4.3 (A2), J4.4 (B2), J4.21 (A11), J4.22 (B11), J4.41 (A21), J4.42 (B21), J4.47 (A24), J4.48 (B24), J4.69 (A35), J4.70 (B35), J5.3 (A2), J5.4 (B2), J5.21 (A11), J5.22 (B11), J5.41 (A21), J5.42 (B21), J5.47 (A24), J5.48 (B24), J5.69 (A35), J5.70 (B35), J6.3 (A2), J6.4 (B2), J6.21 (A11), J6.22 (B11), J6.41 (A21), J6.42 (B21), J6.47 (A24), J6.48 (B24), J6.69 (A35), J6.70 (B35), J7.3 (GND), J7.5 (GND), J7.7 (GND), J7.15 (GND), J7.17 (GND), J7.18 (GND), J7.19 (GND), J7.24 (GND), J8.3, J8.4, J8.21, J8.22, J8.41, J8.42, J8.47, J8.48, J8.69, J8.70, J9.3 (A2), J9.4 (B2), J9.21 (A11), J9.22 (B11), J9.41 (A21), J9.42 (B21), J9.47 (A24), J9.48 (B24), J9.69 (A35), J9.70 (B35), J10.3 (A2), J10.4 (B2), J10.21 (A11), J10.22 (B11), J10.41 (A21), J10.42 (B21), J10.47 (A24), J10.48 (B24), J10.69 (A35), J10.70 (B35), J11.3 (A2), J11.4 (B2), J11.21 (A11), J11.22 (B11), J11.41 (A21), J11.42 (B21), J11.47 (A24), J11.48 (B24), J11.69 (A35), J11.70 (B35), J12.3 (A2), J12.4 (B2), J12.21 (A11), J12.22 (B11), J12.41 (A21), J12.42 (B21), J12.47 (A24), J12.48 (B24), J12.69 (A35), J12.70 (B35), J13.3 (A2), J13.4 (B2), J13.21 (A11), J13.22 (B11), J13.41 (A21), J13.42 (B21), J13.47 (A24), J13.48 (B24), J13.69 (A35), J13.70 (B35), J14.3 (A2), J14.4 (B2), J14.21 (A11), J14.22 (B11), J14.41 (A21), J14.42 (B21), J14.47 (A24), J14.48 (B24), J14.69 (A35), J14.70 (B35), SW1.2, SW1.4, SW1.5 (K), U1.7 (GND), U2.1 (~R), U2.7 (GND); also elsewhere on the board
unnamed: C1.1, R1.2, U1.3
unnamed: C2.1, R4.2, U1.1
unnamed: R2.2, R4.1, SW1.1, SW1.3
unnamed: R3.1, SW1.6 (A)
unnamed: U1.4, U1.5
unnamed: U1.2, U2.3 (C)
unnamed: U2.2 (D), U2.6 (~Q)
unnamed: U1.6, U2.4 (~S)
VCC: J7.9 (+5VSB), R1.1, R2.1, U1.9, U1.11, U1.13, U1.14 (VCC), U2.10 (~S), U2.11 (C), U2.12 (D), U2.13 (~R), U2.14 (VCC); also elsewhere on the board

Notes on the sheet:
ATX POWER CONNECTOR
This is a basic active low Power-On-Reset with a small RC delay.
Basic switch debounce.
ATX POWER ON CIRCUIT
ESD Protection

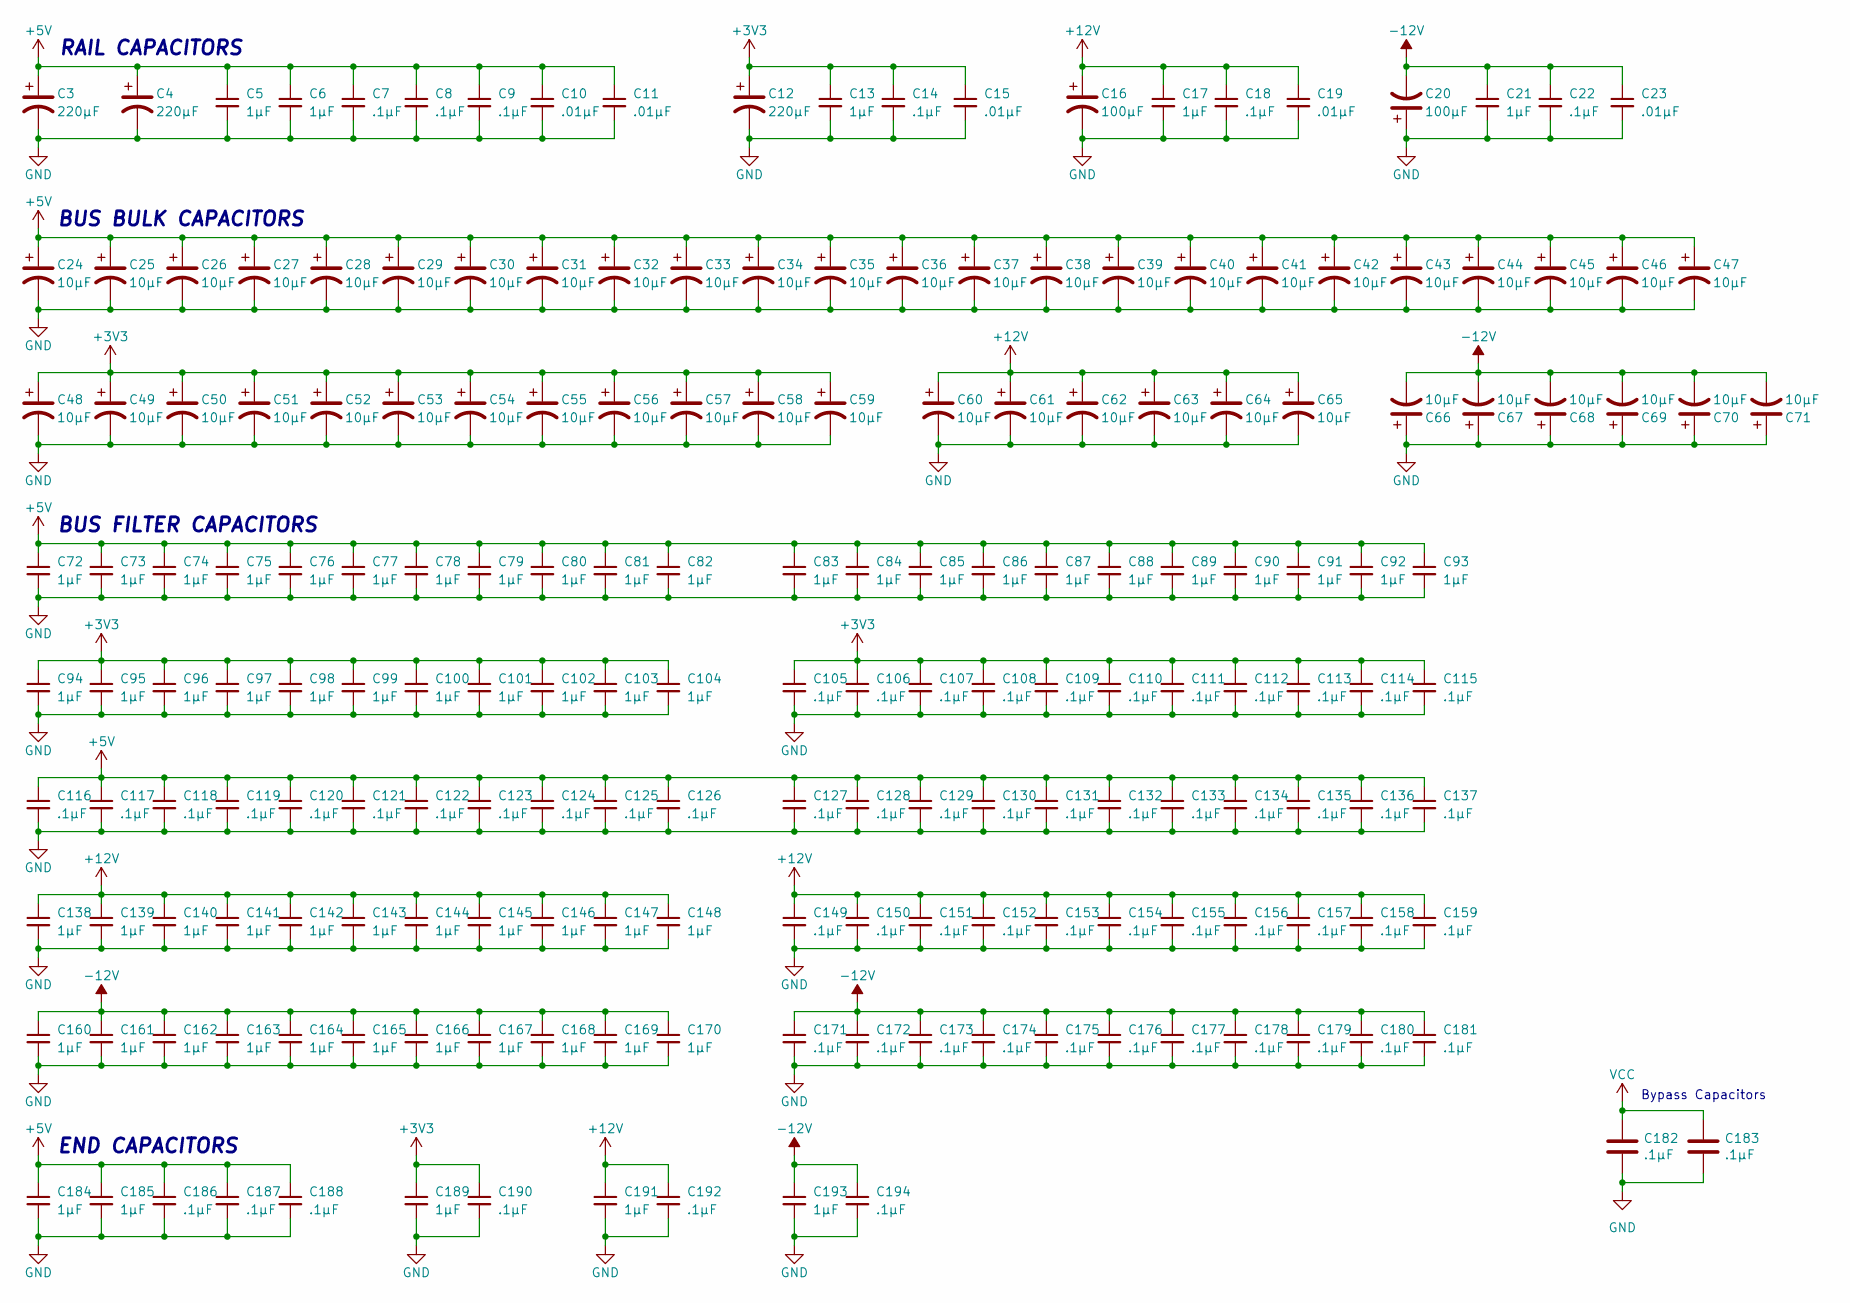
[picture p5: schematic Caps.kicad_sch]

Parts:
C3, C4, C12: 220µF; CP_Elec_6.3x7.7; Manufacturer_Part_Number UCD1C221MCL1GS
C5, C6, C13, C17, C21, C72, C73, C74, C75, C76, C77, C78, C79, C80, C81, C82, C83, C84, C85, C86, C87, C88, C89, C90, C91, C92, C93, C94, C95, C96, C97, C98, C99, C100, C101, C102, C103, C104, C138, C139, C140, C141, C142, C143, C144, C145, C146, C147, C148, C160, C161, C162, C163, C164, C165, C166, C167, C168, C169, C170, C184, C185, C189, C191, C193: 1µF; C_0805_2012Metric_Pad1.18x1.45mm_HandSolder; Manufacturer_Part_Number CL21B105KBFNNNG
C7, C8, C9, C14, C18, C22, C105, C106, C107, C108, C109, C110, C111, C112, C113, C114, C115, C116, C117, C118, C119, C120, C121, C122, C123, C124, C125, C126, C127, C128, C129, C130, C131, C132, C133, C134, C135, C136, C137, C149, C150, C151, C152, C153, C154, C155, C156, C157, C158, C159, C171, C172, C173, C174, C175, C176, C177, C178, C179, C180, C181, C182, C183, C186, C187, C188, C190, C192, C194: .1µF; C_0805_2012Metric_Pad1.18x1.45mm_HandSolder; Manufacturer_Part_Number CL21B104KBFNNNG
C10, C11, C15, C19, C23: .01µF; C_0805_2012Metric_Pad1.18x1.45mm_HandSolder; Manufacturer_Part_Number CL21B103KBCNNNC
C16, C20: 100µF; CP_Elec_6.3x7.7; Manufacturer_Part_Number UCD1E101MCL1GS
C24, C25, C26, C27, C28, C29, C30, C31, C32, C33, C34, C35, C36, C37, C38, C39, C40, C41, C42, C43, C44, C45, C46, C47, C48, C49, C50, C51, C52, C53, C54, C55, C56, C57, C58, C59, C60, C61, C62, C63, C64, C65, C66, C67, C68, C69, C70, C71: 10µF; CP_Elec_4x5.8; Manufacturer_Part_Number UCD1E100MCL1GS

Connections:
+3V3: C12.1, C13.1, C14.1, C15.1, C48.1, C49.1, C50.1, C51.1, C52.1, C53.1, C54.1, C55.1, C56.1, C57.1, C58.1, C59.1, C94.1, C95.1, C96.1, C97.1, C98.1, C99.1, C100.1, C101.1, C102.1, C103.1, C104.1, C105.1, C106.1, C107.1, C108.1, C109.1, C110.1, C111.1, C112.1, C113.1, C114.1, C115.1, C189.1, C190.1; also elsewhere on the board
+5V: C3.1, C4.1, C5.1, C6.1, C7.1, C8.1, C9.1, C10.1, C11.1, C24.1, C25.1, C26.1, C27.1, C28.1, C29.1, C30.1, C31.1, C32.1, C33.1, C34.1, C35.1, C36.1, C37.1, C38.1, C39.1, C40.1, C41.1, C42.1, C43.1, C44.1, C45.1, C46.1, C47.1, C72.1, C73.1, C74.1, C75.1, C76.1, C77.1, C78.1, C79.1, C80.1, C81.1, C82.1, C83.1, C84.1, C85.1, C86.1, C87.1, C88.1, C89.1, C90.1, C91.1, C92.1, C93.1, C116.1, C117.1, C118.1, C119.1, C120.1, C121.1, C122.1, C123.1, C124.1, C125.1, C126.1, C127.1, C128.1, C129.1, C130.1, C131.1, C132.1, C133.1, C134.1, C135.1, C136.1, C137.1, C184.1, C185.1, C186.1, C187.1, C188.1; also elsewhere on the board
+12V: C16.1, C17.1, C18.1, C19.1, C60.1, C61.1, C62.1, C63.1, C64.1, C65.1, C138.1, C139.1, C140.1, C141.1, C142.1, C143.1, C144.1, C145.1, C146.1, C147.1, C148.1, C149.1, C150.1, C151.1, C152.1, C153.1, C154.1, C155.1, C156.1, C157.1, C158.1, C159.1, C191.1, C192.1; also elsewhere on the board
-12V: C20.2, C21.1, C22.1, C23.1, C66.2, C67.2, C68.2, C69.2, C70.2, C71.2, C160.1, C161.1, C162.1, C163.1, C164.1, C165.1, C166.1, C167.1, C168.1, C169.1, C170.1, C171.1, C172.1, C173.1, C174.1, C175.1, C176.1, C177.1, C178.1, C179.1, C180.1, C181.1, C193.1, C194.1; also elsewhere on the board
GND: C3.2, C4.2, C5.2, C6.2, C7.2, C8.2, C9.2, C10.2, C11.2, C12.2, C13.2, C14.2, C15.2, C16.2, C17.2, C18.2, C19.2, C20.1, C21.2, C22.2, C23.2, C24.2, C25.2, C26.2, C27.2, C28.2, C29.2, C30.2, C31.2, C32.2, C33.2, C34.2, C35.2, C36.2, C37.2, C38.2, C39.2, C40.2, C41.2, C42.2, C43.2, C44.2, C45.2, C46.2, C47.2, C48.2, C49.2, C50.2, C51.2, C52.2, C53.2, C54.2, C55.2, C56.2, C57.2, C58.2, C59.2, C60.2, C61.2, C62.2, C63.2, C64.2, C65.2, C66.1, C67.1, C68.1, C69.1, C70.1, C71.1, C72.2, C73.2, C74.2, C75.2, C76.2, C77.2, C78.2, C79.2, C80.2, C81.2, C82.2, C83.2, C84.2, C85.2, C86.2, C87.2, C88.2, C89.2, C90.2, C91.2, C92.2, C93.2, C94.2, C95.2, C96.2, C97.2, C98.2, C99.2, C100.2, C101.2, C102.2, C103.2, C104.2, C105.2, C106.2, C107.2, C108.2, C109.2, C110.2, C111.2, C112.2, C113.2, C114.2, C115.2, C116.2, C117.2, C118.2, C119.2, C120.2, C121.2, C122.2, C123.2, C124.2, C125.2, C126.2, C127.2, C128.2, C129.2, C130.2, C131.2, C132.2, C133.2, C134.2, C135.2, C136.2, C137.2, C138.2, C139.2, C140.2, C141.2, C142.2, C143.2, C144.2, C145.2, C146.2, C147.2, C148.2, C149.2, C150.2, C151.2, C152.2, C153.2, C154.2, C155.2, C156.2, C157.2, C158.2, C159.2, C160.2, C161.2, C162.2, C163.2, C164.2, C165.2, C166.2, C167.2, C168.2, C169.2, C170.2, C171.2, C172.2, C173.2, C174.2, C175.2, C176.2, C177.2, C178.2, C179.2, C180.2, C181.2, C182.2, C183.2, C184.2, C185.2, C186.2, C187.2, C188.2, C189.2, C190.2, C191.2, C192.2, C193.2, C194.2; also elsewhere on the board
VCC: C182.1, C183.1; also elsewhere on the board

Notes on the sheet:
BUS BULK CAPACITORS
END CAPACITORS
RAIL CAPACITORS
Bypass Capacitors
BUS FILTER CAPACITORS

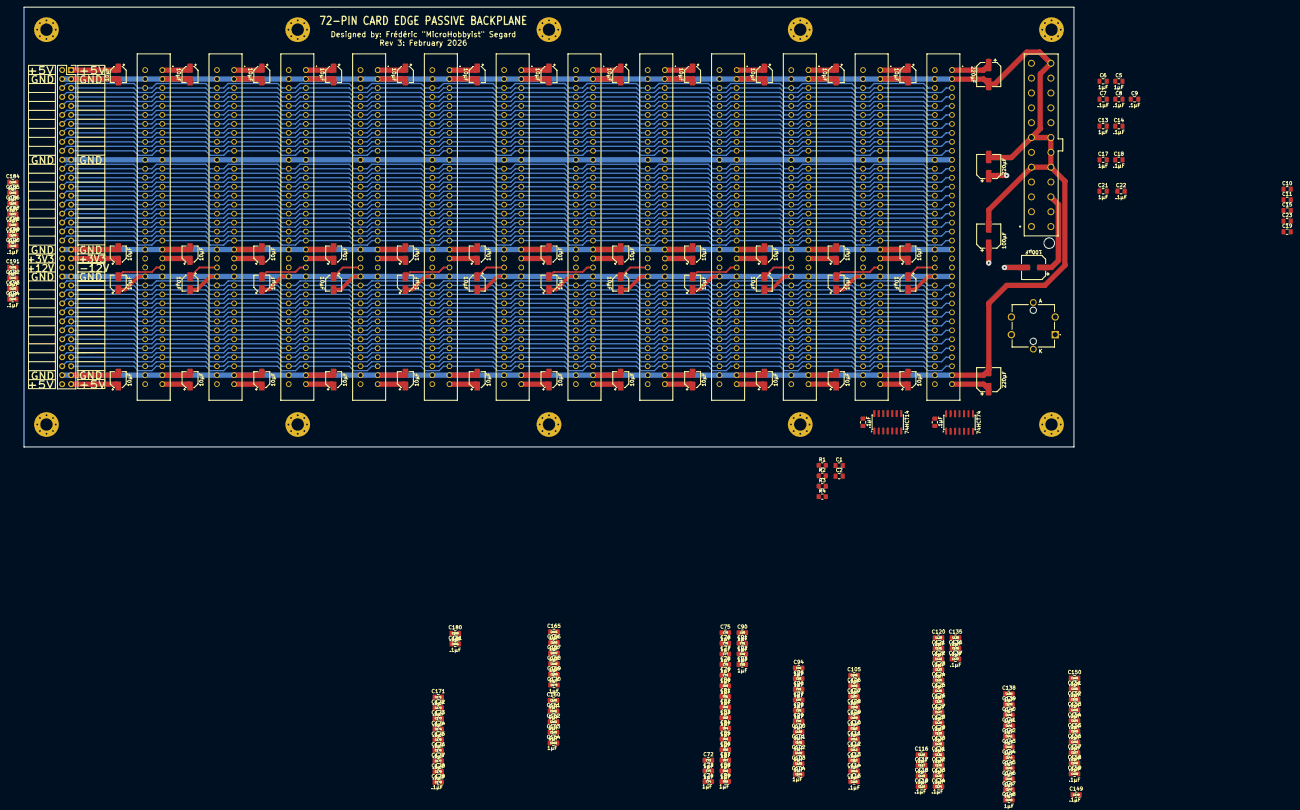
[picture p6: board Episode4.kicad_pcb from above]

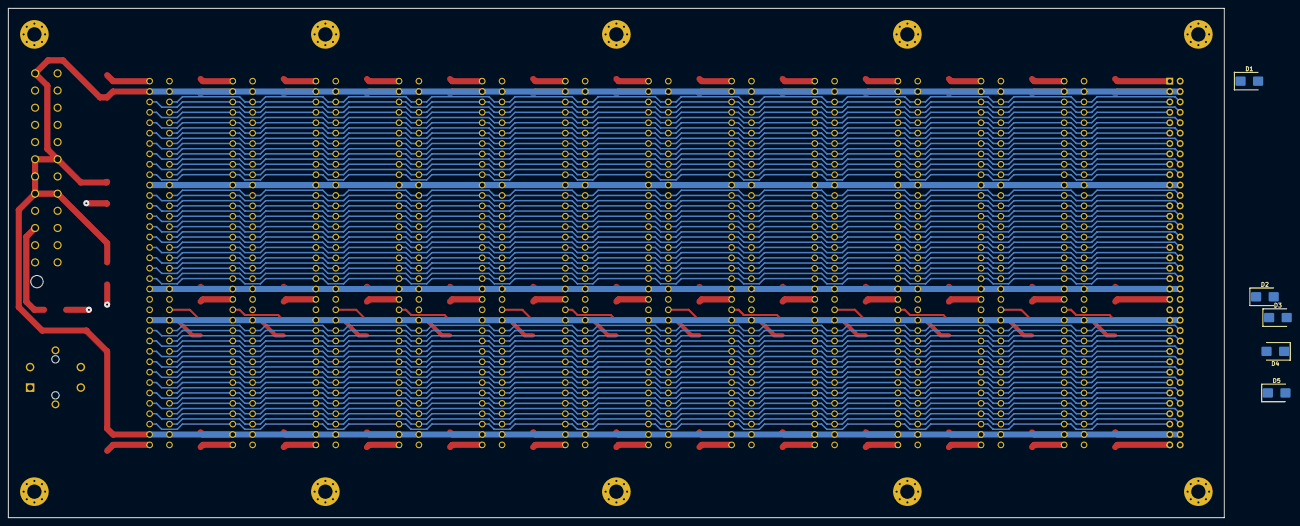
[picture p7: board Episode4.kicad_pcb from below]

Board: 4 copper layers, 297.2 x 124.5 mm, 230 parts (5 on the bottom side), 69 nets.
