microhobbyist/6309-Unleashed-2.0/Episode1/NOP testing the HD63C09/NOP testing the HD63C09.kicad_sch

## KiCad design Episode1/NOP testing the HD63C09/NOP testing the HD63C09.kicad_sch (2025-09-25)

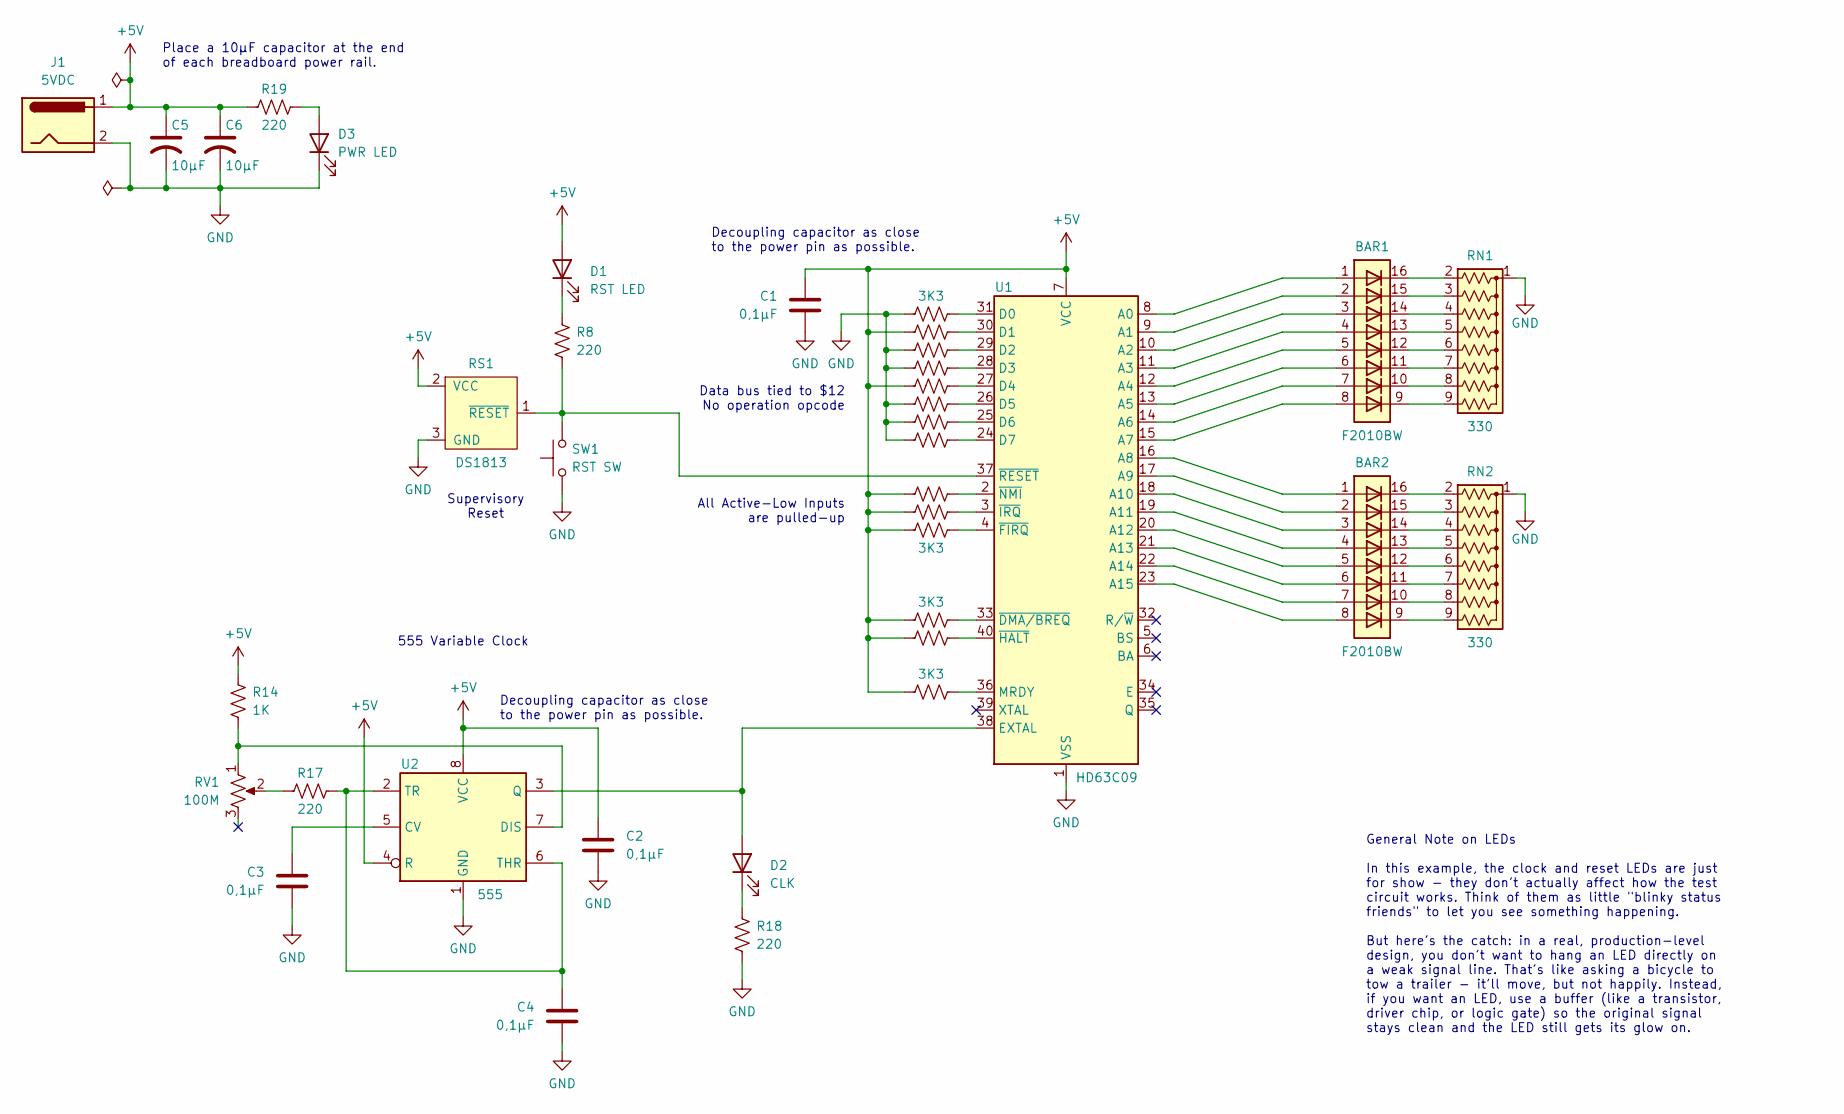
[picture p8: schematic NOP testing the HD63C09.kicad_sch]

Parts:
BAR1, BAR2: F2010BW
C1, C2, C3, C4: 0,1µF
C5, C6: 10µF
D1: RST LED
D2: CLK
D3: PWR LED
J1: 5VDC
R1, R2, R3, R4, R5, R6, R7, R9, R10, R11, R12, R13, R15, R16: 3K3
R8, R17, R18, R19: 220
R14: 1K
RN1, RN2: 330; R_Array_SIP9
RS1: DS1813; TO-92L_HandSolder
RV1: 100M
SW1: RST SW
U1: HD63C09; DIP-40_W15.24mm
U2: 555; DIP-8_W7.62mm

Connections:
+5V: C1.1, C2.1, C5.1, C6.1, D1.2 (A), J1.1, R2.1, R5.1, R10.1, R11.1, R12.1, R13.1, R14.2, R15.1, R16.1, R19.1, RS1.2 (VCC), U1.7 (VCC), U2.4 (R), U2.8 (VCC)
GND: C1.2, C2.2, C3.2, C4.2, C5.2, C6.2, D3.1 (K), J1.2, R1.1, R3.1, R4.1, R6.1, R7.1, R9.1, R18.1, RN1.1 (common), RN2.1 (common), RS1.3 (GND), SW1.1, U1.1 (VSS), U2.1 (GND)
unnamed: BAR1.1 (A), U1.8 (A0)
unnamed: BAR1.2 (A), U1.9 (A1)
unnamed: BAR1.3 (A), U1.10 (A2)
unnamed: BAR1.4 (A), U1.11 (A3)
unnamed: BAR1.5 (A), U1.12 (A4)
unnamed: BAR1.6 (A), U1.13 (A5)
unnamed: BAR1.7 (A), U1.14 (A6)
unnamed: BAR1.8 (A), U1.15 (A7)
unnamed: BAR1.9 (A), RN1.9 (R8)
unnamed: BAR1.10 (A), RN1.8 (R7)
unnamed: BAR1.11 (K), RN1.7 (R6)
unnamed: BAR1.12 (K), RN1.6 (R5)
unnamed: BAR1.13 (K), RN1.5 (R4)
unnamed: BAR1.14 (K), RN1.4 (R3)
unnamed: BAR1.15 (K), RN1.3 (R2)
unnamed: BAR1.16 (K), RN1.2 (R1)
unnamed: BAR2.1 (A), U1.16 (A8)
unnamed: BAR2.2 (A), U1.17 (A9)
unnamed: BAR2.3 (A), U1.18 (A10)
unnamed: BAR2.4 (A), U1.19 (A11)
unnamed: BAR2.5 (A), U1.20 (A12)
unnamed: BAR2.6 (A), U1.21 (A13)
unnamed: BAR2.7 (A), U1.22 (A14)
unnamed: BAR2.8 (A), U1.23 (A15)
unnamed: BAR2.9 (A), RN2.9 (R8)
unnamed: BAR2.10 (A), RN2.8 (R7)
unnamed: BAR2.11 (K), RN2.7 (R6)
unnamed: BAR2.12 (K), RN2.6 (R5)
unnamed: BAR2.13 (K), RN2.5 (R4)
unnamed: BAR2.14 (K), RN2.4 (R3)
unnamed: BAR2.15 (K), RN2.3 (R2)
unnamed: BAR2.16 (K), RN2.2 (R1)
unnamed: C3.1, U2.5 (CV)
unnamed: C4.1, R17.2, U2.2 (TR), U2.6 (THR)
unnamed: D1.1 (K), R8.2
unnamed: D2.1 (K), R18.2
unnamed: D2.2 (A), U1.38 (EXTAL), U2.3 (Q)
unnamed: D3.2 (A), R19.2
unnamed: R1.2, U1.31 (D0)
unnamed: R2.2, U1.30 (D1)
unnamed: R3.2, U1.29 (D2)
unnamed: R4.2, U1.28 (D3)
unnamed: R5.2, U1.27 (D4)
unnamed: R6.2, U1.26 (D5)
unnamed: R7.2, U1.25 (D6)
unnamed: R8.1, RS1.1 (~RESET), SW1.2, U1.37 (~RESET)
unnamed: R9.2, U1.24 (D7)
unnamed: R10.2, U1.2 (~NMI)
unnamed: R11.2, U1.3 (~IRQ)
unnamed: R12.2, U1.4 (~FIRQ)
unnamed: R13.2, U1.33 (~DMA/BREQ)
unnamed: R14.1, RV1.1, U2.7 (DIS)
unnamed: R15.2, U1.40 (~HALT)
unnamed: R16.2, U1.36 (MRDY)
unnamed: R17.1, RV1.2

Notes on the sheet:
Place a 10µF capacitor at the end of each breadboard power rail.
Data bus tied to $12 No operation opcode
Decoupling capacitor as close to the power pin as possible.
Supervisory Reset
555 Variable Clock
All Active-Low Inputs are pulled-up
General Note on LEDs In this example, the clock and reset LEDs are just for show - they don't actually affect how the test circuit works. Think of them as little "blinky status friends" to let you see something happening. But here's the catch: in a real, production-level design, you don't want to h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
