microhobbyist/6309-Unleashed-2.0/Episode2/Reset, CPU and Buffers/CPU_RESET_BUFFERS.kicad_sch

## KiCad design Episode2/Reset, CPU and Buffers/CPU_RESET_BUFFERS.kicad_sch (2025-09-24)

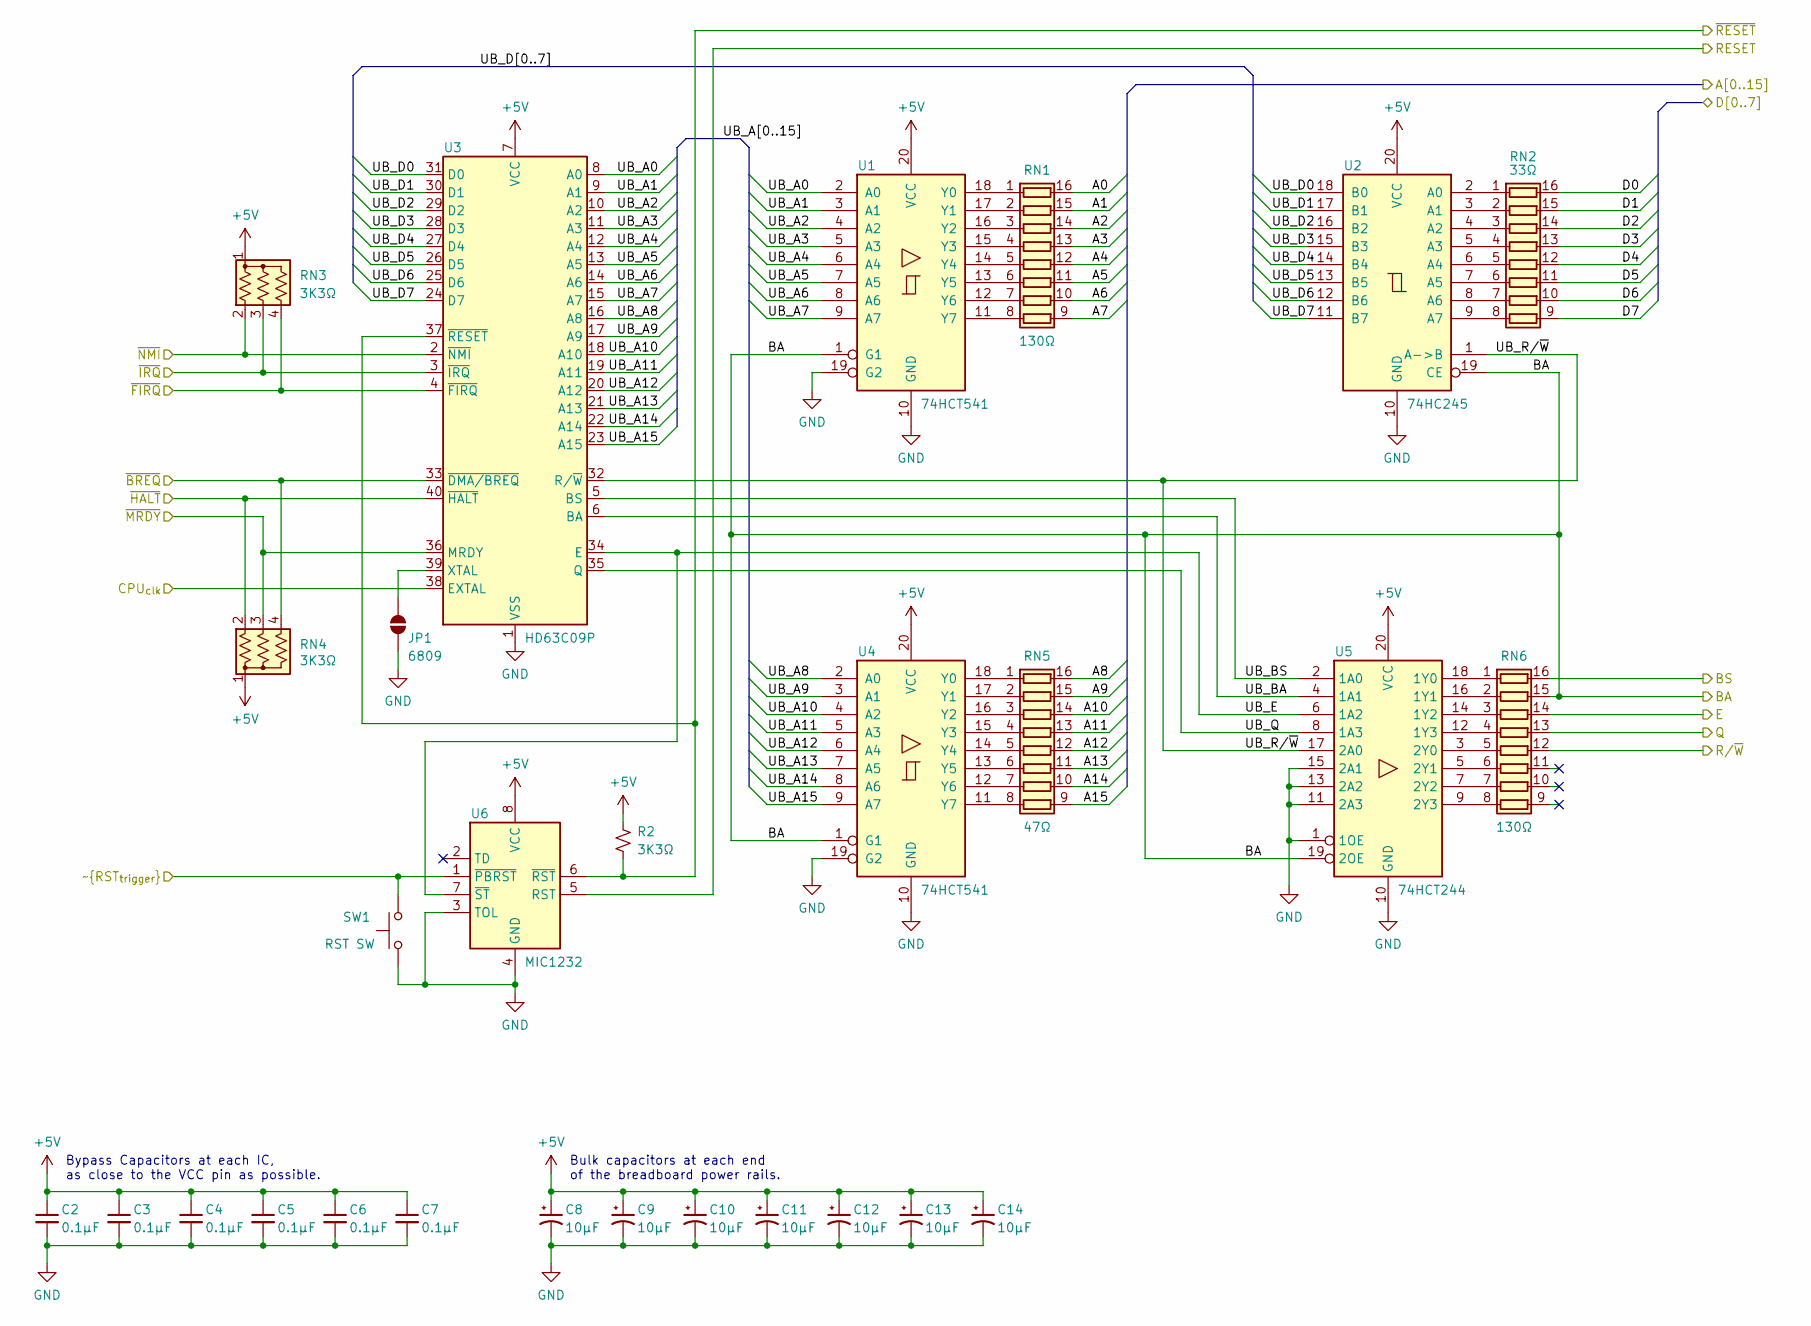
[picture p9: schematic CPU_RESET_BUFFERS.kicad_sch]

Parts:
C2, C3, C4, C5, C6, C7: 0.1µF
C8, C9, C10, C11, C12, C13, C14: 10µF
JP1: 6809
R2: 3K3Ω
RN1, RN6: 130Ω; DIP-16_W7.62mm
RN2: 33Ω; DIP-16_W7.62mm
RN3, RN4: 3K3Ω; R_Array_SIP4
RN5: 47Ω; DIP-16_W7.62mm
SW1: RST SW
U1, U4: 74HCT541; DIP-20_W7.62mm_Socket
U2: 74HC245; DIP-20_W7.62mm_Socket
U3: HD63C09P; DIP-40_W15.24mm_Socket
U5: 74HCT244; DIP-20_W7.62mm_Socket
U6: MIC1232; DIP-8_W7.62mm_Socket

Connections:
+5V: C2.1, C3.1, C4.1, C5.1, C6.1, C7.1, C8.1, C9.1, C10.1, C11.1, C12.1, C13.1, C14.1, R2.1, RN3.1 (common), RN4.1 (common), U1.20 (VCC), U2.20 (VCC), U3.7 (VCC), U4.20 (VCC), U5.20 (VCC), U6.8 (VCC)
A0: RN1.16 (R1.2)
A1: RN1.15 (R2.2)
A2: RN1.14 (R3.2)
A3: RN1.13 (R4.2)
A4: RN1.12 (R5.2)
A5: RN1.11 (R6.2)
A6: RN1.10 (R7.2)
A7: RN1.9 (R8.2)
A8: RN5.16 (R1.2)
A9: RN5.15 (R2.2)
A10: RN5.14 (R3.2)
A11: RN5.13 (R4.2)
A12: RN5.12 (R5.2)
A13: RN5.11 (R6.2)
A14: RN5.10 (R7.2)
A15: RN5.9 (R8.2)
BA: RN6.15 (R2.2), U1.1 (G1), U2.19 (CE), U4.1 (G1), U5.19 (2OE)
BS: RN6.16 (R1.2)
CPU_{clk}: U3.38 (EXTAL)
D0: RN2.16 (R1.2)
D1: RN2.15 (R2.2)
D2: RN2.14 (R3.2)
D3: RN2.13 (R4.2)
D4: RN2.12 (R5.2)
D5: RN2.11 (R6.2)
D6: RN2.10 (R7.2)
D7: RN2.9 (R8.2)
E: RN6.14 (R3.2)
GND: C2.2, C3.2, C4.2, C5.2, C6.2, C7.2, C8.2, C9.2, C10.2, C11.2, C12.2, C13.2, C14.2, JP1.1 (A), SW1.1, U1.10 (GND), U1.19 (G2), U2.10 (GND), U3.1 (VSS), U4.10 (GND), U4.19 (G2), U5.1 (1OE), U5.10 (GND), U5.11 (2A3), U5.13 (2A2), U5.15 (2A1), U6.3 (TOL), U6.4 (GND)
unnamed: JP1.2 (B), U3.39 (XTAL)
unnamed: RN1.1 (R1.1), U1.18 (Y0)
unnamed: RN1.2 (R2.1), U1.17 (Y1)
unnamed: RN1.3 (R3.1), U1.16 (Y2)
unnamed: RN1.4 (R4.1), U1.15 (Y3)
unnamed: RN1.5 (R5.1), U1.14 (Y4)
unnamed: RN1.6 (R6.1), U1.13 (Y5)
unnamed: RN1.7 (R7.1), U1.12 (Y6)
unnamed: RN1.8 (R8.1), U1.11 (Y7)
unnamed: RN2.1 (R1.1), U2.2 (A0)
unnamed: RN2.2 (R2.1), U2.3 (A1)
unnamed: RN2.3 (R3.1), U2.4 (A2)
unnamed: RN2.4 (R4.1), U2.5 (A3)
unnamed: RN2.5 (R5.1), U2.6 (A4)
unnamed: RN2.6 (R6.1), U2.7 (A5)
unnamed: RN2.7 (R7.1), U2.8 (A6)
unnamed: RN2.8 (R8.1), U2.9 (A7)
unnamed: RN5.1 (R1.1), U4.18 (Y0)
unnamed: RN5.2 (R2.1), U4.17 (Y1)
unnamed: RN5.3 (R3.1), U4.16 (Y2)
unnamed: RN5.4 (R4.1), U4.15 (Y3)
unnamed: RN5.5 (R5.1), U4.14 (Y4)
unnamed: RN5.6 (R6.1), U4.13 (Y5)
unnamed: RN5.7 (R7.1), U4.12 (Y6)
unnamed: RN5.8 (R8.1), U4.11 (Y7)
unnamed: RN6.1 (R1.1), U5.18 (1Y0)
unnamed: RN6.2 (R2.1), U5.16 (1Y1)
unnamed: RN6.3 (R3.1), U5.14 (1Y2)
unnamed: RN6.4 (R4.1), U5.12 (1Y3)
unnamed: RN6.5 (R5.1), U5.3 (2Y0)
unnamed: RN6.6 (R6.1), U5.5 (2Y1)
unnamed: RN6.7 (R7.1), U5.7 (2Y2)
unnamed: RN6.8 (R8.1), U5.9 (2Y3)
Q: RN6.13 (R4.2)
RESET: U6.5 (RST)
R/~W: RN6.12 (R5.2)
UB_A0: U1.2 (A0), U3.8 (A0)
UB_A1: U1.3 (A1), U3.9 (A1)
UB_A2: U1.4 (A2), U3.10 (A2)
UB_A3: U1.5 (A3), U3.11 (A3)
UB_A4: U1.6 (A4), U3.12 (A4)
UB_A5: U1.7 (A5), U3.13 (A5)
UB_A6: U1.8 (A6), U3.14 (A6)
UB_A7: U1.9 (A7), U3.15 (A7)
UB_A8: U3.16 (A8), U4.2 (A0)
UB_A9: U3.17 (A9), U4.3 (A1)
UB_A10: U3.18 (A10), U4.4 (A2)
UB_A11: U3.19 (A11), U4.5 (A3)
UB_A12: U3.20 (A12), U4.6 (A4)
UB_A13: U3.21 (A13), U4.7 (A5)
UB_A14: U3.22 (A14), U4.8 (A6)
UB_A15: U3.23 (A15), U4.9 (A7)
UB_BA: U3.6 (BA), U5.4 (1A1)
UB_BS: U3.5 (BS), U5.2 (1A0)
UB_D0: U2.18 (B0), U3.31 (D0)
UB_D1: U2.17 (B1), U3.30 (D1)
UB_D2: U2.16 (B2), U3.29 (D2)
UB_D3: U2.15 (B3), U3.28 (D3)
UB_D4: U2.14 (B4), U3.27 (D4)
UB_D5: U2.13 (B5), U3.26 (D5)
UB_D6: U2.12 (B6), U3.25 (D6)
UB_D7: U2.11 (B7), U3.24 (D7)
UB_E: U3.34 (E), U5.6 (1A2), U6.7 (~ST)
UB_Q: U3.35 (Q), U5.8 (1A3)
UB_R/~W: U2.1 (A->B), U3.32 (R/~W), U5.17 (2A0)
~BREQ: RN4.4 (R3), U3.33 (~DMA/BREQ)
~FIRQ: RN3.4 (R3), U3.4 (~FIRQ)
~HALT: RN4.2 (R1), U3.40 (~HALT)
~IRQ: RN3.3 (R2), U3.3 (~IRQ)
~MRDY: RN4.3 (R2), U3.36 (MRDY)
~NMI: RN3.2 (R1), U3.2 (~NMI)
~RESET: R2.2, U3.37 (~RESET), U6.6 (~RST)
~RST_{trigger}: SW1.2, U6.1 (~PBRST)

Notes on the sheet:
Bypass Capacitors at each IC, as close to the VCC pin as possible.
Bulk capacitors at each end of the breadboard power rails.
