microhobbyist/6309-Unleashed-2.0/Episode2/Reset, CPU and Buffers/Reset, CPU and Buffers.kicad_sch

## KiCad design Episode2/Reset, CPU and Buffers/Reset, CPU and Buffers.kicad_sch (2025-09-25)

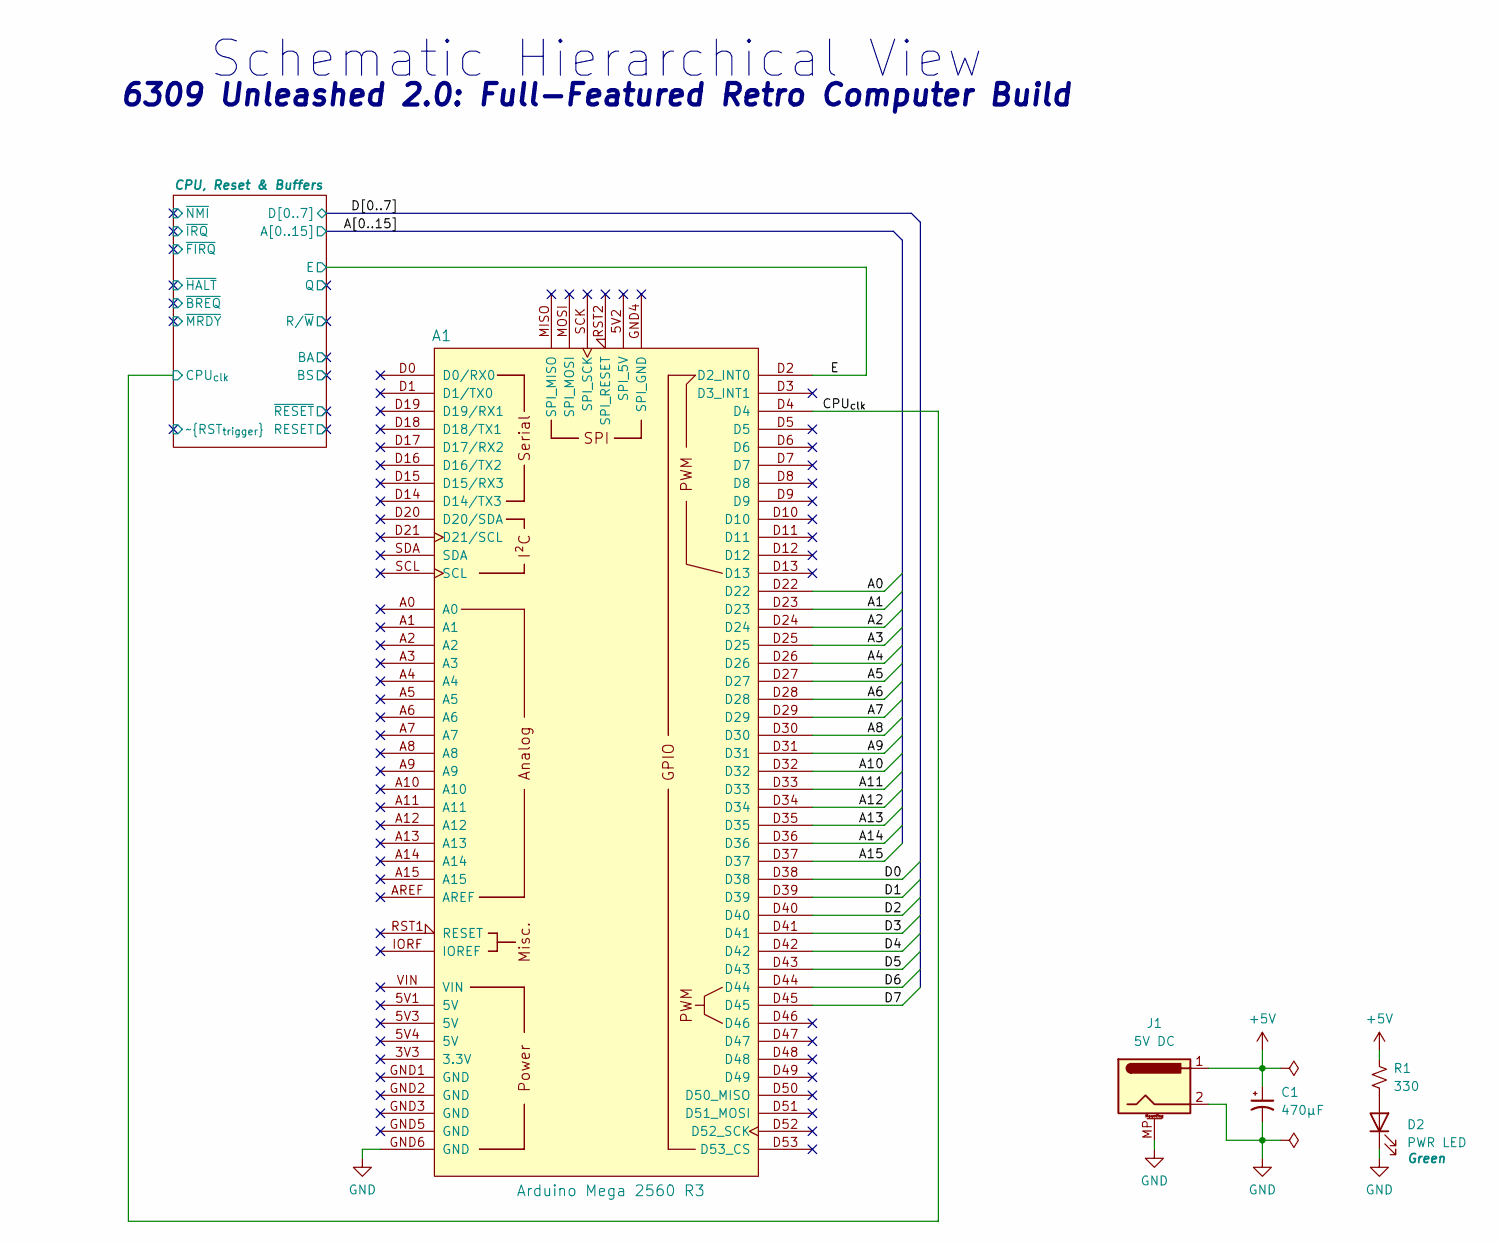
[picture p10: schematic Reset, CPU and Buffers.kicad_sch]

Parts:
A1: Arduino Mega 2560 R3
C1: 470µF
D2: PWR LED
J1: 5V DC
R1: 330

Connections:
+5V: C1.1, J1.1, R1.1
A0: A1.D22
A1: A1.D23
A2: A1.D24
A3: A1.D25
A4: A1.D26
A5: A1.D27
A6: A1.D28
A7: A1.D29
A8: A1.D30
A9: A1.D31
A10: A1.D32
A11: A1.D33
A12: A1.D34
A13: A1.D35
A14: A1.D36
A15: A1.D37
CPU_{clk}: A1.D4
D0: A1.D38
D1: A1.D39
D2: A1.D40
D3: A1.D41
D4: A1.D42
D5: A1.D43
D6: A1.D44
D7: A1.D45
E: A1.D2 (D2_INT0)
GND: A1.GND6 (GND), C1.2, D2.1 (K), J1.2, J1.MP (MountPin)
unnamed: D2.2 (A), R1.2

Notes on the sheet:
6309 Unleashed 2.0: Full-Featured Retro Computer Build
Schematic Hierarchical View
