microhobbyist/6309-Unleashed-2.0/Episode3/Glue Logic v2/CPU_RESET_BUFFERS.kicad_sch

## KiCad design Episode3/Glue Logic v2/CPU_RESET_BUFFERS.kicad_sch (2025-12-10)

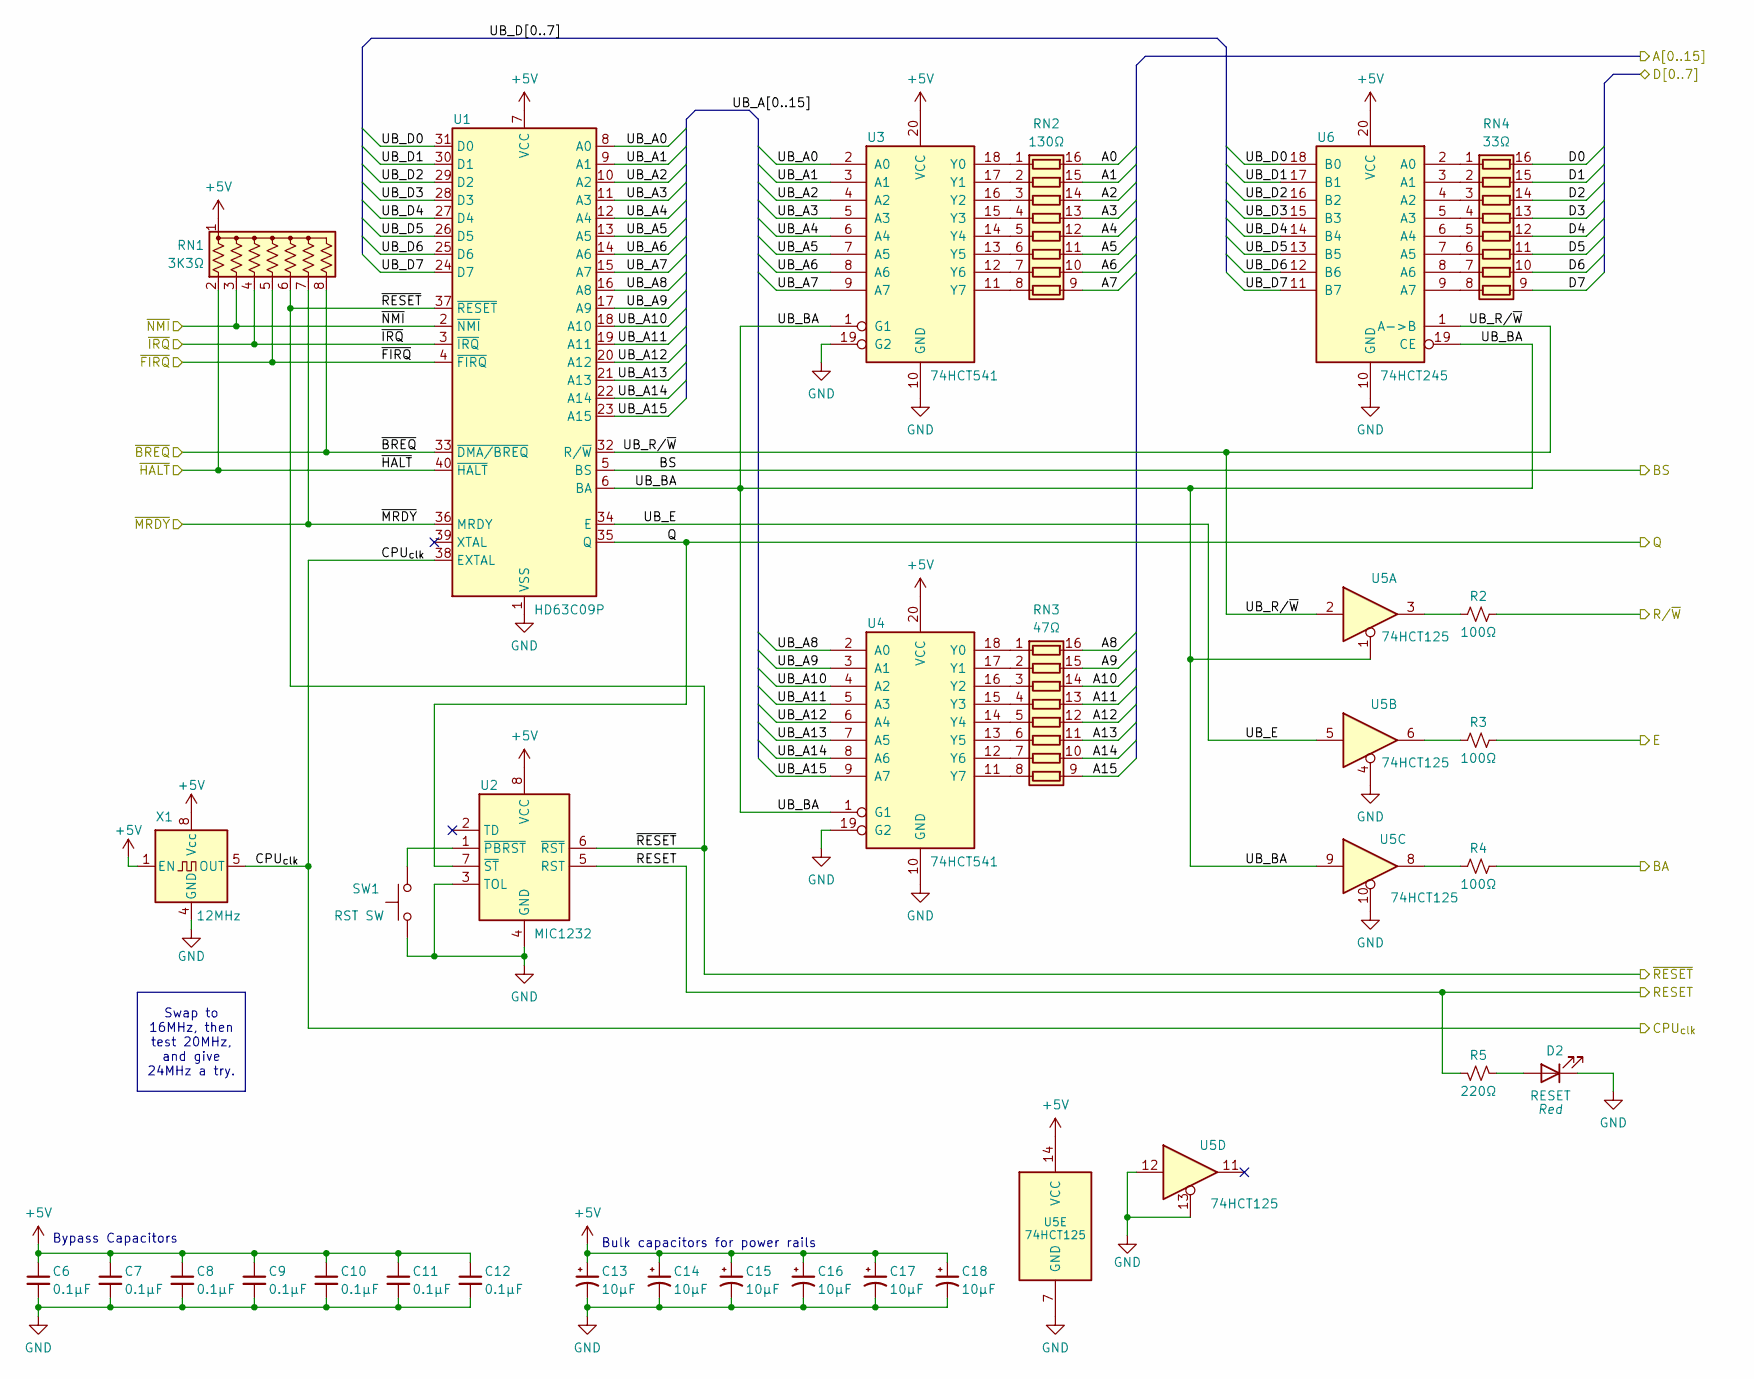
[picture p11: schematic CPU_RESET_BUFFERS.kicad_sch]

Parts:
C6, C7, C8, C9, C10, C11, C12: 0.1µF
C13, C14, C15, C16, C17, C18: 10µF
D2: RESET
R2, R3, R4: 100Ω
R5: 220Ω
RN1: 3K3Ω; R_Array_SIP8
RN2: 130Ω; DIP-16_W7.62mm
RN3: 47Ω; DIP-16_W7.62mm
RN4: 33Ω; DIP-16_W7.62mm
SW1: RST SW
U1: HD63C09P; DIP-40_W15.24mm_Socket
U2: MIC1232; DIP-8_W7.62mm_Socket
U3, U4: 74HCT541; DIP-20_W7.62mm_Socket
U5: 74HCT125
U6: 74HCT245; DIP-20_W7.62mm_Socket
X1: 12MHz; Oscillator_DIP-8

Connections:
+5V: C6.1, C7.1, C8.1, C9.1, C10.1, C11.1, C12.1, C13.1, C14.1, C15.1, C16.1, C17.1, C18.1, RN1.1 (common), U1.7 (VCC), U2.8 (VCC), U3.20 (VCC), U4.20 (VCC), U5.14 (VCC), U6.20 (VCC), X1.1 (EN), X1.8 (Vcc)
A0: RN2.16 (R1.2)
A1: RN2.15 (R2.2)
A2: RN2.14 (R3.2)
A3: RN2.13 (R4.2)
A4: RN2.12 (R5.2)
A5: RN2.11 (R6.2)
A6: RN2.10 (R7.2)
A7: RN2.9 (R8.2)
A8: RN3.16 (R1.2)
A9: RN3.15 (R2.2)
A10: RN3.14 (R3.2)
A11: RN3.13 (R4.2)
A12: RN3.12 (R5.2)
A13: RN3.11 (R6.2)
A14: RN3.10 (R7.2)
A15: RN3.9 (R8.2)
BA: R4.2
BS: U1.5 (BS)
CPU_{clk}: U1.38 (EXTAL), X1.5 (OUT)
D0: RN4.16 (R1.2)
D1: RN4.15 (R2.2)
D2: RN4.14 (R3.2)
D3: RN4.13 (R4.2)
D4: RN4.12 (R5.2)
D5: RN4.11 (R6.2)
D6: RN4.10 (R7.2)
D7: RN4.9 (R8.2)
E: R3.2
GND: C6.2, C7.2, C8.2, C9.2, C10.2, C11.2, C12.2, C13.2, C14.2, C15.2, C16.2, C17.2, C18.2, D2.1 (K), SW1.1, U1.1 (VSS), U2.3 (TOL), U2.4 (GND), U3.10 (GND), U3.19 (G2), U4.10 (GND), U4.19 (G2), U5.4, U5.7 (GND), U5.10, U5.12, U5.13, U6.10 (GND), X1.4 (GND)
unnamed: D2.2 (A), R5.2
unnamed: R2.1, U5.3
unnamed: R3.1, U5.6
unnamed: R4.1, U5.8
unnamed: RN2.1 (R1.1), U3.18 (Y0)
unnamed: RN2.2 (R2.1), U3.17 (Y1)
unnamed: RN2.3 (R3.1), U3.16 (Y2)
unnamed: RN2.4 (R4.1), U3.15 (Y3)
unnamed: RN2.5 (R5.1), U3.14 (Y4)
unnamed: RN2.6 (R6.1), U3.13 (Y5)
unnamed: RN2.7 (R7.1), U3.12 (Y6)
unnamed: RN2.8 (R8.1), U3.11 (Y7)
unnamed: RN3.1 (R1.1), U4.18 (Y0)
unnamed: RN3.2 (R2.1), U4.17 (Y1)
unnamed: RN3.3 (R3.1), U4.16 (Y2)
unnamed: RN3.4 (R4.1), U4.15 (Y3)
unnamed: RN3.5 (R5.1), U4.14 (Y4)
unnamed: RN3.6 (R6.1), U4.13 (Y5)
unnamed: RN3.7 (R7.1), U4.12 (Y6)
unnamed: RN3.8 (R8.1), U4.11 (Y7)
unnamed: RN4.1 (R1.1), U6.2 (A0)
unnamed: RN4.2 (R2.1), U6.3 (A1)
unnamed: RN4.3 (R3.1), U6.4 (A2)
unnamed: RN4.4 (R4.1), U6.5 (A3)
unnamed: RN4.5 (R5.1), U6.6 (A4)
unnamed: RN4.6 (R6.1), U6.7 (A5)
unnamed: RN4.7 (R7.1), U6.8 (A6)
unnamed: RN4.8 (R8.1), U6.9 (A7)
unnamed: SW1.2, U2.1 (~PBRST)
Q: U1.35 (Q), U2.7 (~ST)
RESET: R5.1, U2.5 (RST)
R/~W: R2.2
UB_A0: U1.8 (A0), U3.2 (A0)
UB_A1: U1.9 (A1), U3.3 (A1)
UB_A2: U1.10 (A2), U3.4 (A2)
UB_A3: U1.11 (A3), U3.5 (A3)
UB_A4: U1.12 (A4), U3.6 (A4)
UB_A5: U1.13 (A5), U3.7 (A5)
UB_A6: U1.14 (A6), U3.8 (A6)
UB_A7: U1.15 (A7), U3.9 (A7)
UB_A8: U1.16 (A8), U4.2 (A0)
UB_A9: U1.17 (A9), U4.3 (A1)
UB_A10: U1.18 (A10), U4.4 (A2)
UB_A11: U1.19 (A11), U4.5 (A3)
UB_A12: U1.20 (A12), U4.6 (A4)
UB_A13: U1.21 (A13), U4.7 (A5)
UB_A14: U1.22 (A14), U4.8 (A6)
UB_A15: U1.23 (A15), U4.9 (A7)
UB_BA: U1.6 (BA), U3.1 (G1), U4.1 (G1), U5.1, U5.9, U6.19 (CE)
UB_D0: U1.31 (D0), U6.18 (B0)
UB_D1: U1.30 (D1), U6.17 (B1)
UB_D2: U1.29 (D2), U6.16 (B2)
UB_D3: U1.28 (D3), U6.15 (B3)
UB_D4: U1.27 (D4), U6.14 (B4)
UB_D5: U1.26 (D5), U6.13 (B5)
UB_D6: U1.25 (D6), U6.12 (B6)
UB_D7: U1.24 (D7), U6.11 (B7)
UB_E: U1.34 (E), U5.5
UB_R/~W: U1.32 (R/~W), U5.2, U6.1 (A->B)
~BREQ: RN1.8 (R7), U1.33 (~DMA/BREQ)
~FIRQ: RN1.5 (R4), U1.4 (~FIRQ)
~HALT: RN1.2 (R1), U1.40 (~HALT)
~IRQ: RN1.4 (R3), U1.3 (~IRQ)
~MRDY: RN1.7 (R6), U1.36 (MRDY)
~NMI: RN1.3 (R2), U1.2 (~NMI)
~RESET: RN1.6 (R5), U1.37 (~RESET), U2.6 (~RST)

Notes on the sheet:
Bypass Capacitors
Bulk capacitors for power rails
Swap to 16MHz, then test 20MHz, and give 24MHz a try.
