microhobbyist/6309-Unleashed-2.0/Episode3/Glue Logic v2/Glue Logic v2.kicad_sch

## KiCad design Episode3/Glue Logic v2/Glue Logic v2.kicad_sch (2026-02-07)

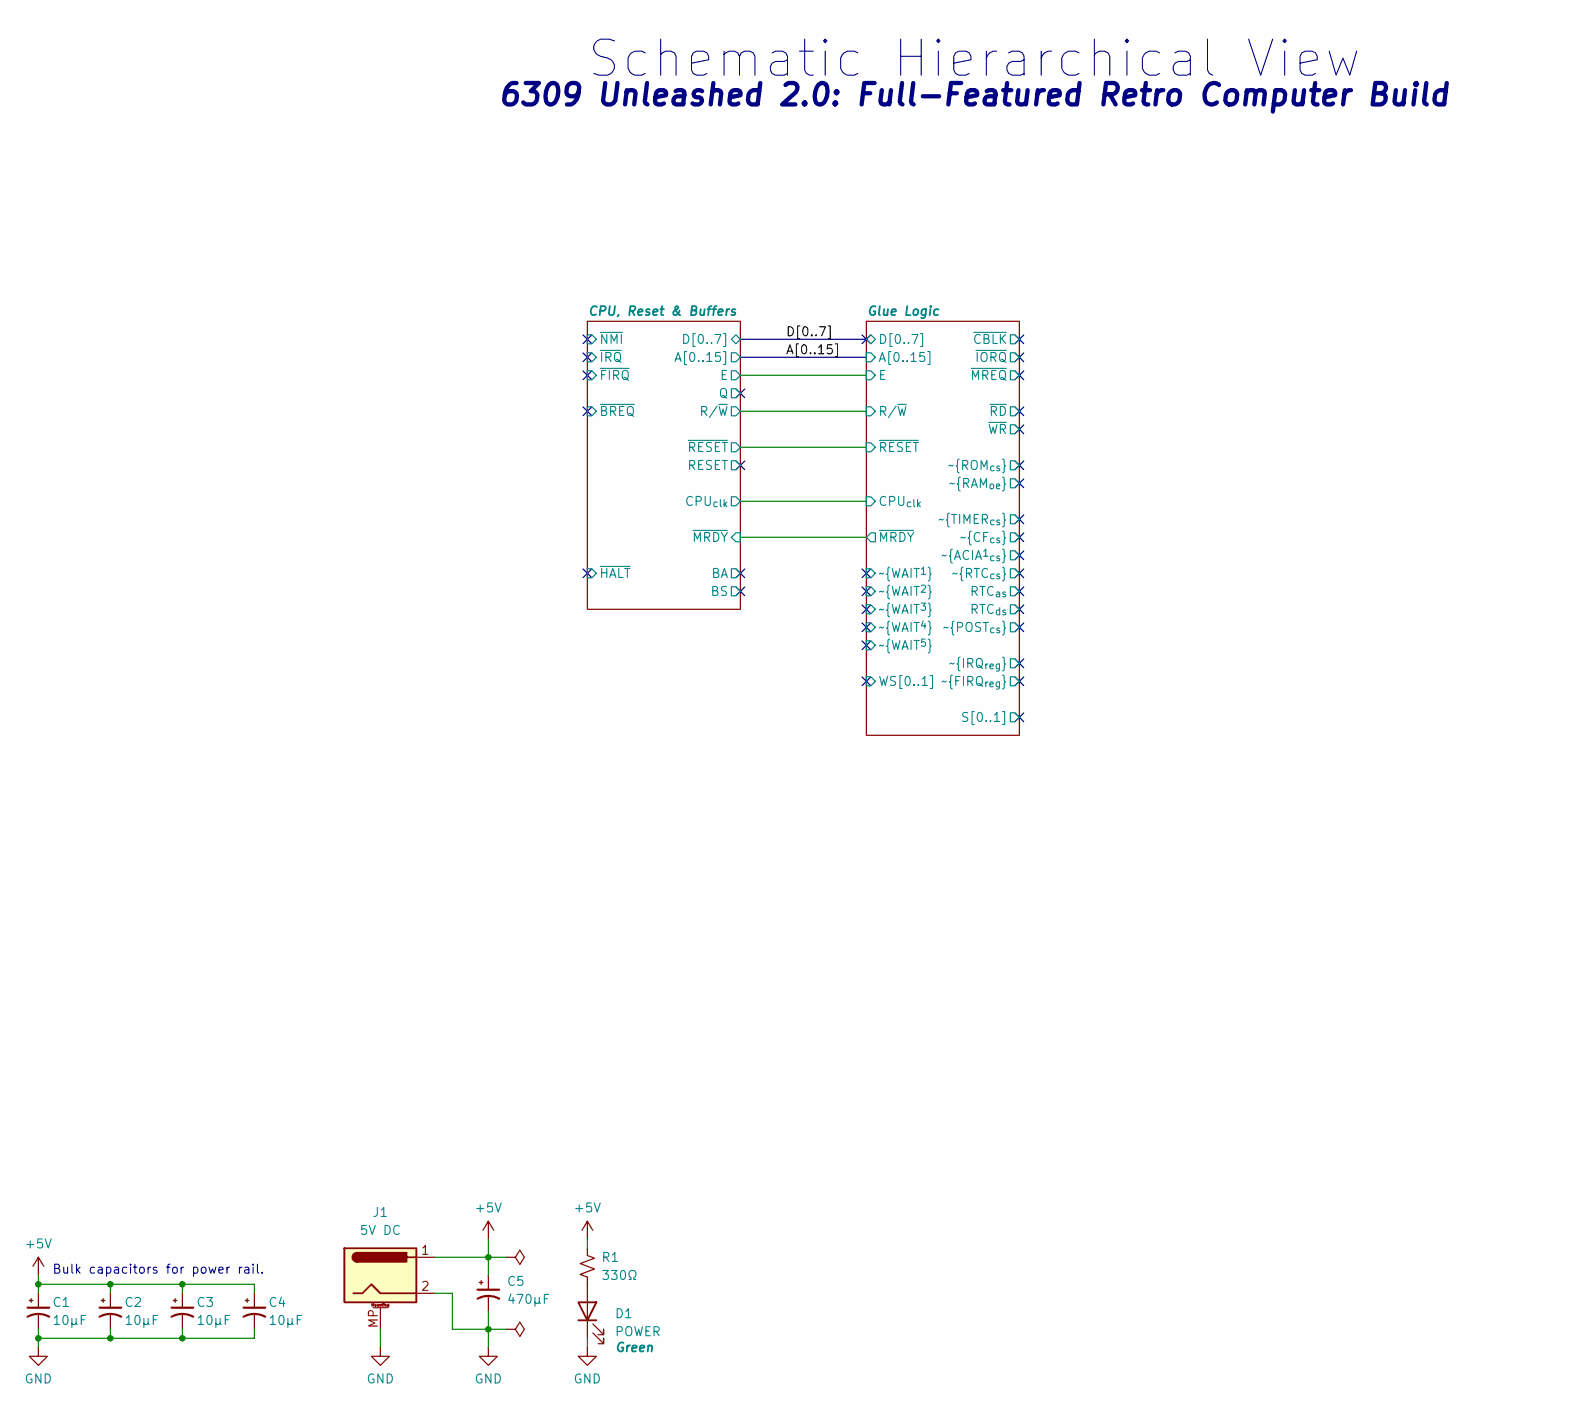
[picture p12: schematic Glue Logic v2.kicad_sch]

Parts:
C1, C2, C3, C4: 10µF
C5: 470µF
D1: POWER
J1: 5V DC
R1: 330Ω

Connections:
+5V: C1.1, C2.1, C3.1, C4.1, C5.1, J1.1, R1.1
GND: C1.2, C2.2, C3.2, C4.2, C5.2, D1.1 (K), J1.2, J1.MP (MountPin)
unnamed: D1.2 (A), R1.2

Notes on the sheet:
6309 Unleashed 2.0: Full-Featured Retro Computer Build
Schematic Hierarchical View
Bulk capacitors for power rail.
