microhobbyist/6309-Unleashed-2.0/Episode3/Glue Logic v2/Glue.kicad_sch

## KiCad design Episode3/Glue Logic v2/Glue.kicad_sch (2026-02-07)

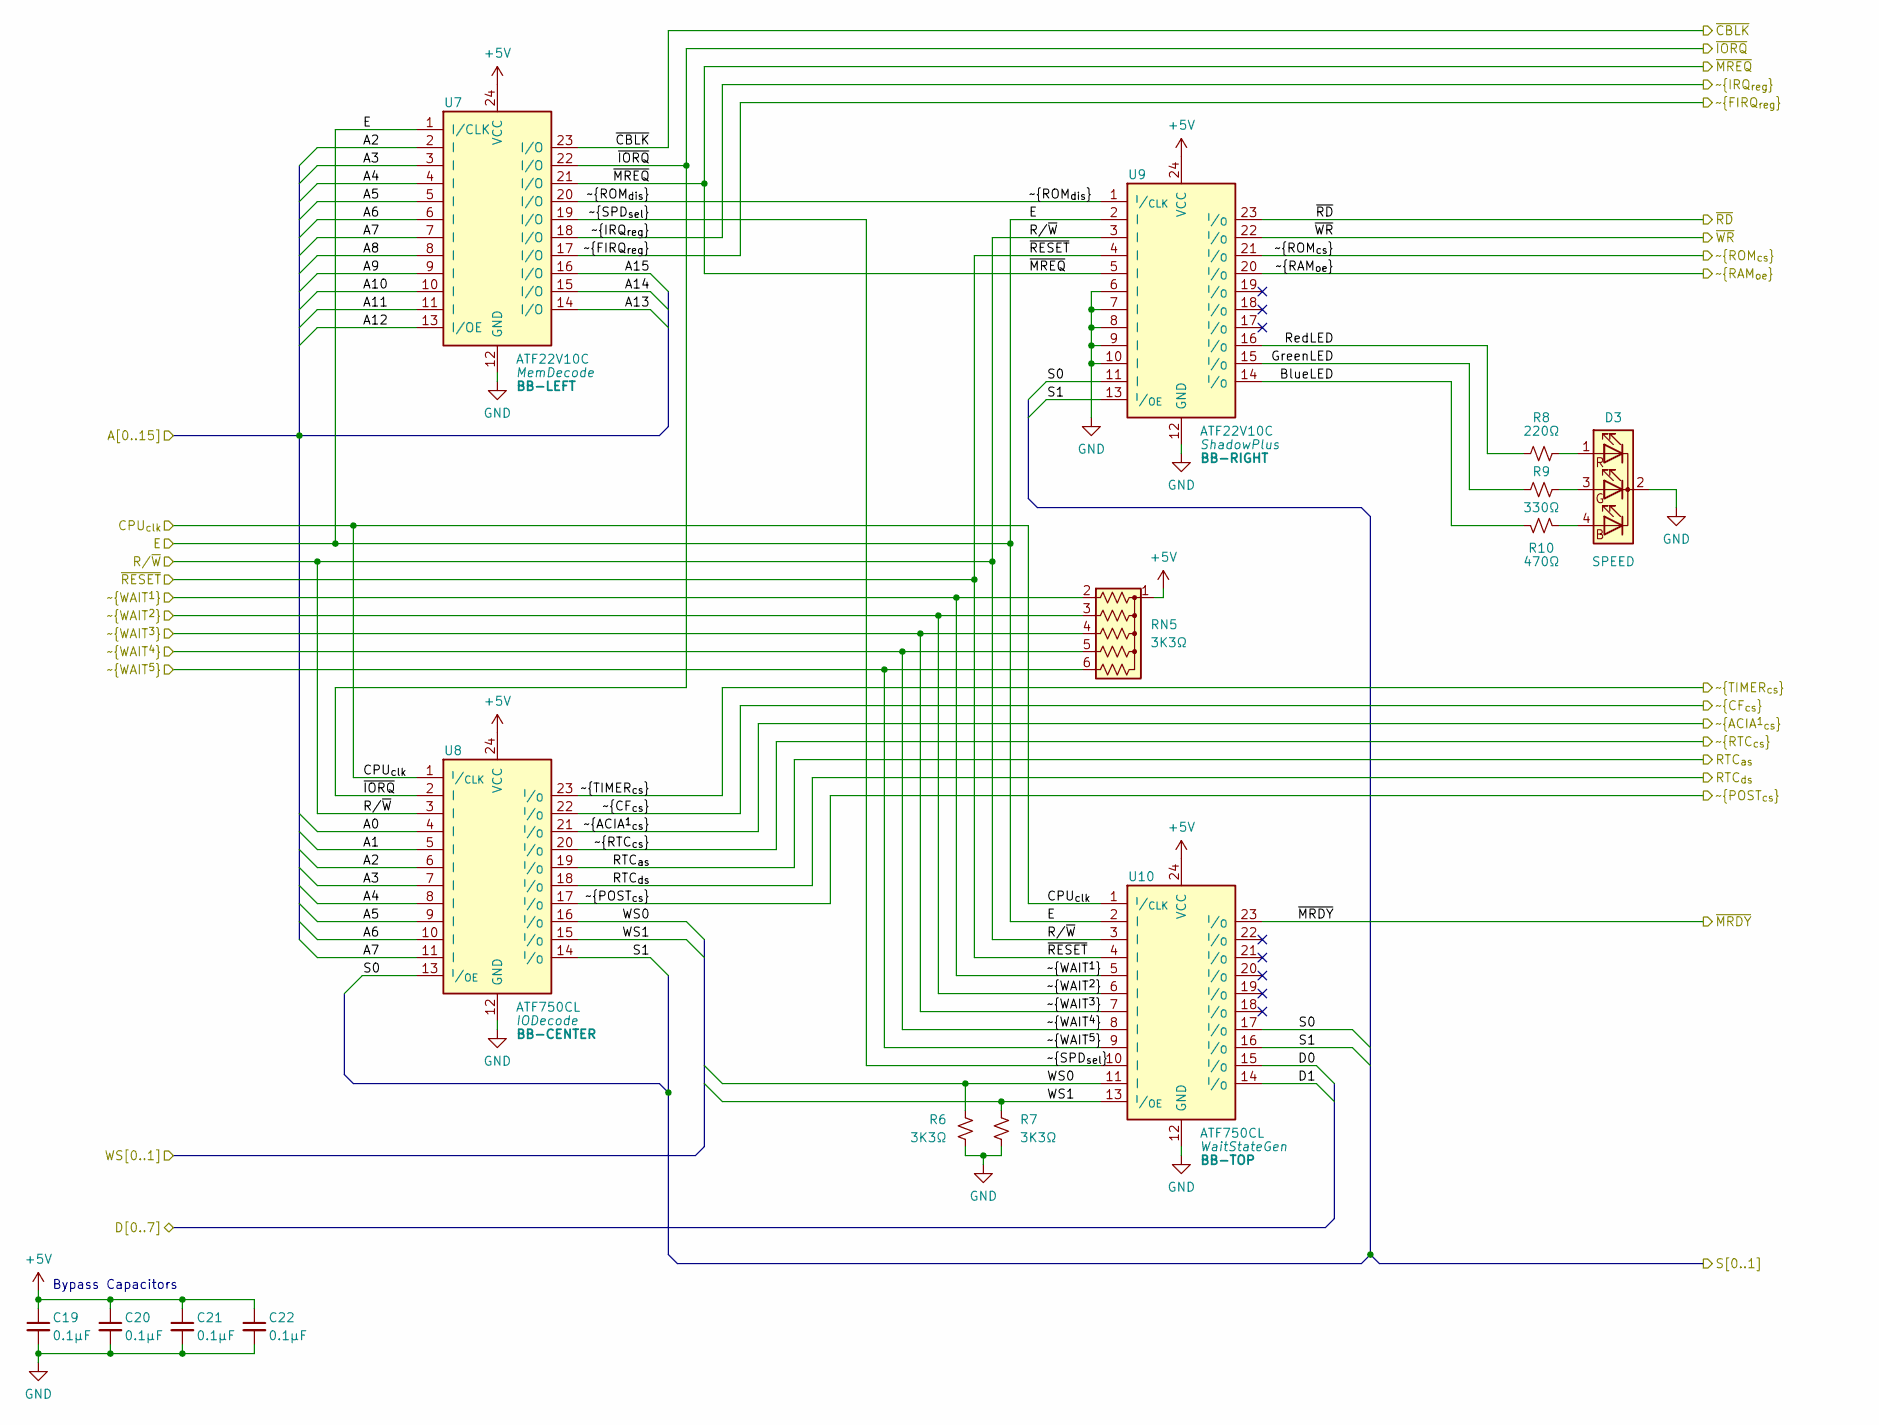
[picture p13: schematic Glue.kicad_sch]

Parts:
C19, C20, C21, C22: 0.1µF
D3: SPEED
R6, R7: 3K3Ω
R8: 220Ω
R9: 330Ω
R10: 470Ω
RN5: 3K3Ω; R_Array_SIP6
U7, U9: ATF22V10C; DIP-24_W7.62mm_Socket_LongPads
U8, U10: ATF750CL; DIP-24_W7.62mm_Socket_LongPads

Connections:
+5V: C19.1, C20.1, C21.1, C22.1, RN5.1 (common), U7.24 (VCC), U8.24 (VCC), U9.24 (VCC), U10.24 (VCC)
A0: U8.4 (I)
A1: U8.5 (I)
A2: U7.2 (I), U8.6 (I)
A3: U7.3 (I), U8.7 (I)
A4: U7.4 (I), U8.8 (I)
A5: U7.5 (I), U8.9 (I)
A6: U7.6 (I), U8.10 (I)
A7: U7.7 (I), U8.11 (I)
A8: U7.8 (I)
A9: U7.9 (I)
A10: U7.10 (I)
A11: U7.11 (I)
A12: U7.13 (I/OE)
A13: U7.14 (I/O)
A14: U7.15 (I/O)
A15: U7.16 (I/O)
BlueLED: R10.1, U9.14 (^{I}/_{O})
CPU_{clk}: U8.1 (^{I}/_{CLK}), U10.1 (^{I}/_{CLK})
D0: U10.15 (^{I}/_{O})
D1: U10.14 (^{I}/_{O})
E: U7.1 (I/CLK), U9.2 (I), U10.2 (I)
GND: C19.2, C20.2, C21.2, C22.2, D3.2 (K), R6.1, R7.1, U7.12 (GND), U8.12 (GND), U9.6 (I), U9.7 (I), U9.8 (I), U9.9 (I), U9.10 (I), U9.12 (GND), U10.12 (GND)
GreenLED: R9.1, U9.15 (^{I}/_{O})
unnamed: D3.1 (RA), R8.2
unnamed: D3.3 (GA), R9.2
unnamed: D3.4 (BA), R10.2
RTC_{as}: U8.19 (^{I}/_{O})
RTC_{ds}: U8.18 (^{I}/_{O})
RedLED: R8.1, U9.16 (^{I}/_{O})
R/~W: U8.3 (I), U9.3 (I), U10.3 (I)
S0: U8.13 (^{I}/_{OE}), U9.11 (I), U10.17 (^{I}/_{O})
S1: U8.14 (^{I}/_{O}), U9.13 (^{I}/_{OE}), U10.16 (^{I}/_{O})
WS0: R6.2, U8.16 (^{I}/_{O}), U10.11 (I)
WS1: R7.2, U8.15 (^{I}/_{O}), U10.13 (^{I}/_{OE})
~ACIA^{1_{cs}}: U8.21 (^{I}/_{O})
~CBLK: U7.23 (I/O)
~CF_{cs}: U8.22 (^{I}/_{O})
~FIRQ_{reg}: U7.17 (I/O)
~IORQ: U7.22 (I/O), U8.2 (I)
~IRQ_{reg}: U7.18 (I/O)
~MRDY: U10.23 (^{I}/_{O})
~MREQ: U7.21 (I/O), U9.5 (I)
~POST_{cs}: U8.17 (^{I}/_{O})
~RAM_{oe}: U9.20 (^{I}/_{O})
~RD: U9.23 (^{I}/_{O})
~RESET: U9.4 (I), U10.4 (I)
~ROM_{cs}: U9.21 (^{I}/_{O})
~ROM_{dis}: U7.20 (I/O), U9.1 (^{I}/_{CLK})
~RTC_{cs}: U8.20 (^{I}/_{O})
~SPD_{sel}: U7.19 (I/O), U10.10 (I)
~TIMER_{cs}: U8.23 (^{I}/_{O})
~WAIT^{1}: RN5.2 (R1), U10.5 (I)
~WAIT^{2}: RN5.3 (R2), U10.6 (I)
~WAIT^{3}: RN5.4 (R3), U10.7 (I)
~WAIT^{4}: RN5.5 (R4), U10.8 (I)
~WAIT^{5}: RN5.6 (R5), U10.9 (I)
~WR: U9.22 (^{I}/_{O})

Notes on the sheet:
Bypass Capacitors
