microhobbyist/6309-Unleashed-2.0/Episode 3/PLDs/PLDs.kicad_sch

## KiCad design Episode 3/PLDs/PLDs.kicad_sch (2025-09-25)

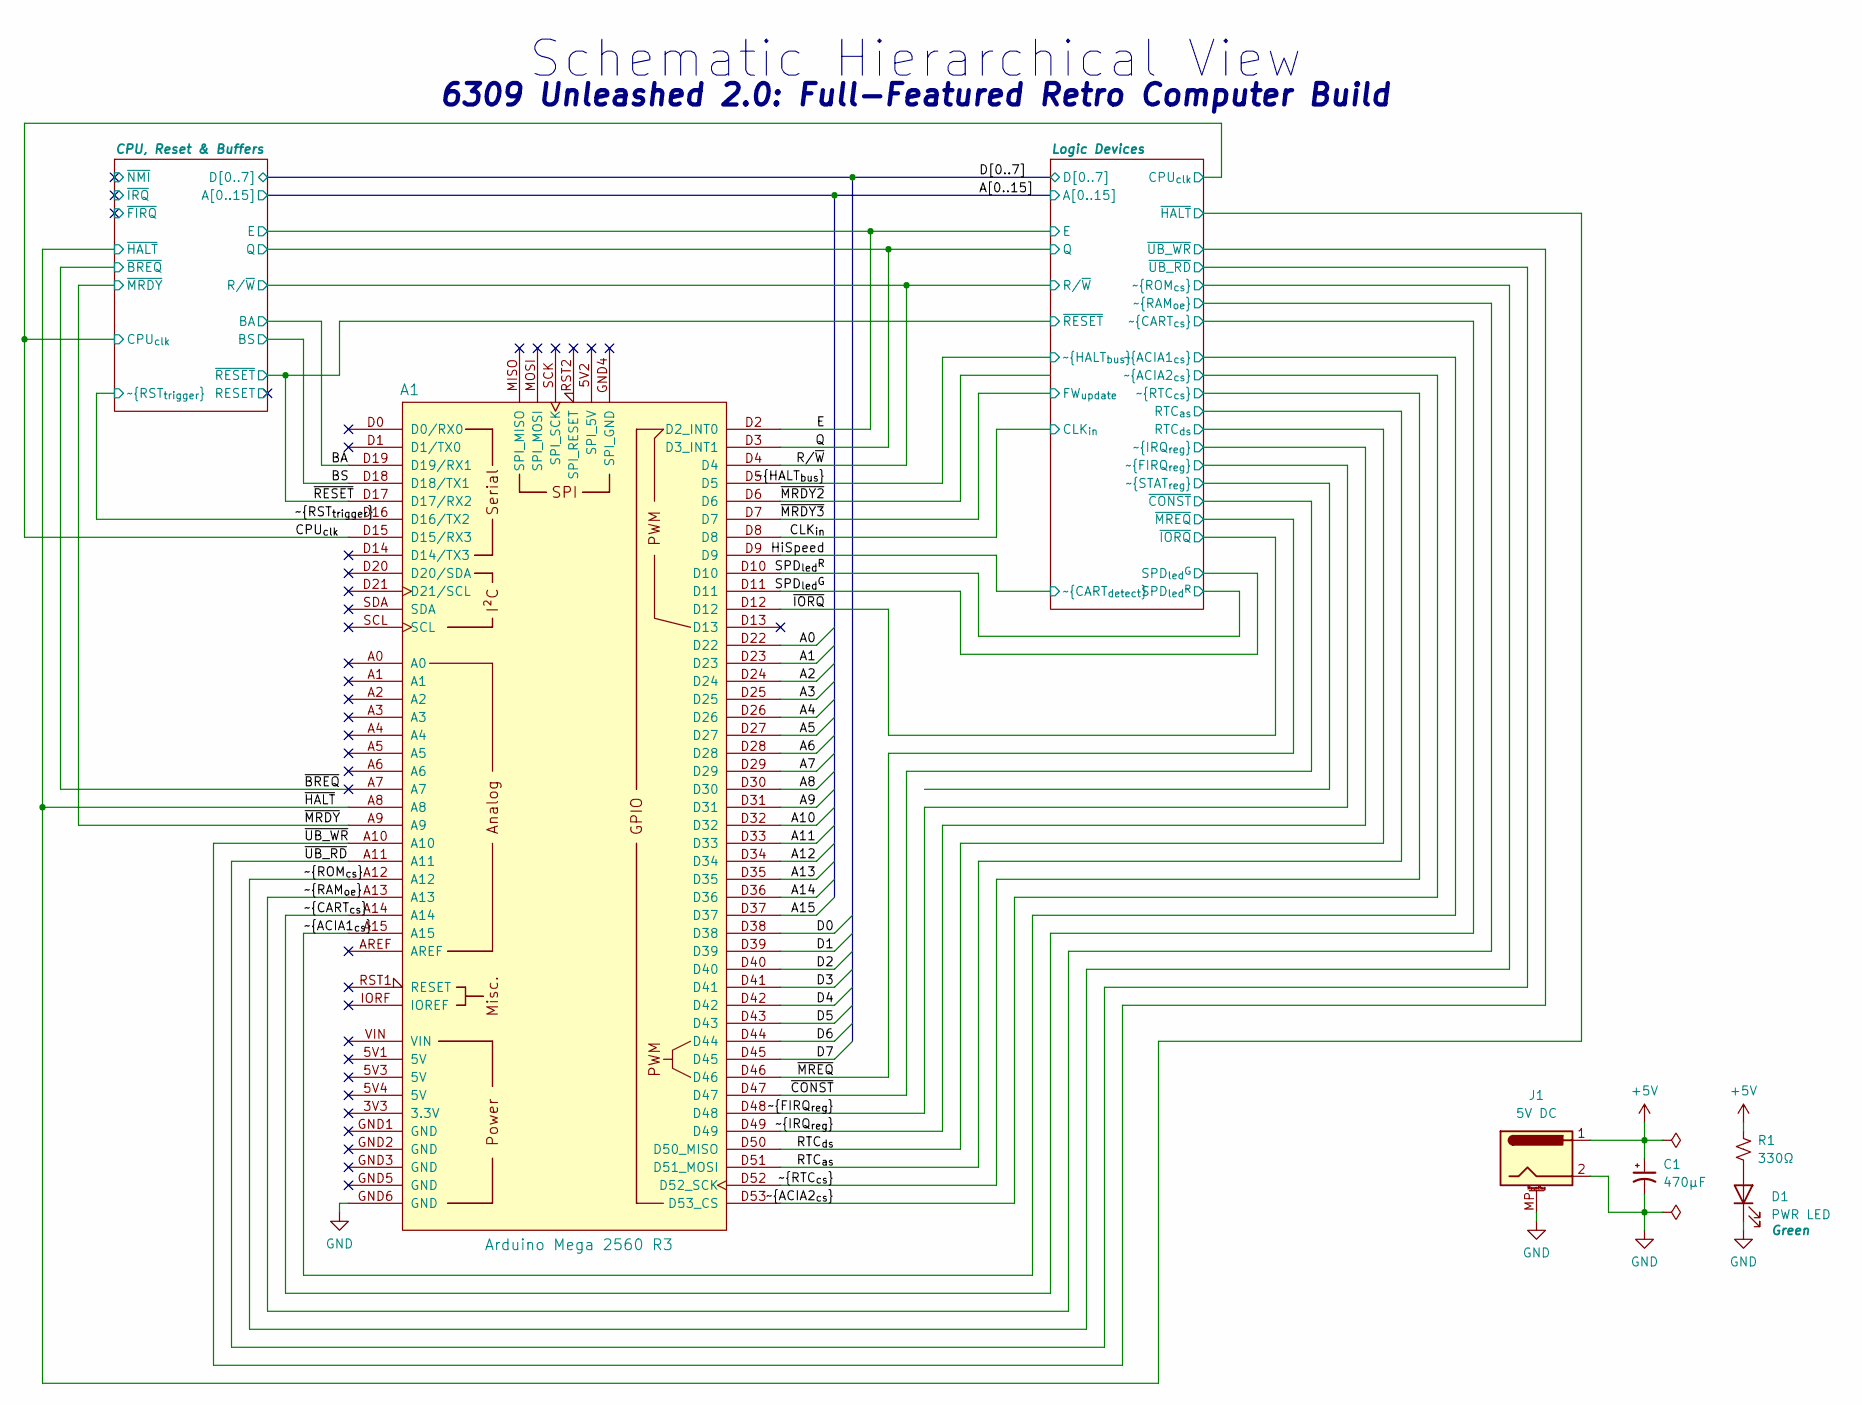
[picture p14: schematic PLDs.kicad_sch]

Parts:
A1: Arduino Mega 2560 R3
C1: 470µF
D1: PWR LED
J1: 5V DC
R1: 330Ω

Connections:
+5V: C1.1, J1.1, R1.1
A0: A1.D22
A1: A1.D23
A2: A1.D24
A3: A1.D25
A4: A1.D26
A5: A1.D27
A6: A1.D28
A7: A1.D29
A8: A1.D30
A9: A1.D31
A10: A1.D32
A11: A1.D33
A12: A1.D34
A13: A1.D35
A14: A1.D36
A15: A1.D37
BA: A1.D19 (D19/RX1)
BS: A1.D18 (D18/TX1)
CLK_{in}: A1.D8
CPU_{clk}: A1.D15 (D15/RX3)
D0: A1.D38
D1: A1.D39
D2: A1.D40
D3: A1.D41
D4: A1.D42
D5: A1.D43
D6: A1.D44
D7: A1.D45
E: A1.D2 (D2_INT0)
GND: A1.GND6 (GND), C1.2, D1.1 (K), J1.2, J1.MP (MountPin)
HiSpeed: A1.D9
unnamed: D1.2 (A), R1.2
Q: A1.D3 (D3_INT1)
RTC_{as}: A1.D51 (D51_MOSI)
RTC_{ds}: A1.D50 (D50_MISO)
R/~W: A1.D4
SPD_{led}^{G}: A1.D11
SPD_{led}^{R}: A1.D10
~ACIA1_{cs}: A1.A15
~ACIA2_{cs}: A1.D53 (D53_CS)
~BREQ: A1.A7
~CART_{cs}: A1.A14
~CONST: A1.D47
~FIRQ_{reg}: A1.D48
~HALT_{bus}: A1.D5
~HALT: A1.A8
~IORQ: A1.D12
~IRQ_{reg}: A1.D49
~MRDY2: A1.D6
~MRDY3: A1.D7
~MRDY: A1.A9
~MREQ: A1.D46
~RAM_{oe}: A1.A13
~RESET: A1.D17 (D17/RX2)
~ROM_{cs}: A1.A12
~RST_{trigger}: A1.D16 (D16/TX2)
~RTC_{cs}: A1.D52 (D52_SCK)
~UB_RD: A1.A11
~UB_WR: A1.A10

Notes on the sheet:
6309 Unleashed 2.0: Full-Featured Retro Computer Build
Schematic Hierarchical View
