microhobbyist/6309-Unleashed-2.0/(commit log)

2025-09-10 Initial Comit
    [NOP testing the HD63C09.kicad_pcb, NOP testing the HD63C09.kicad_sch]
2025-09-11 Shuffled thing a bit (visually)
    [NOP testing the HD63C09.kicad_sch]
2025-09-12 Added the CPU and Reset sheet
    [Buffers.kicad_sch, Reset, CPU and Buffers.kicad_pcb, Reset, CPU and Buffers.kicad_sch, ResetCPU.kicad_sch]
2025-09-13 Fit both sheets into one
    Instead of having one sheet for reset & CPU, and one for bus buffers, I packed everything in one sheet. And it does not look overpacked.
    [Buffers.kicad_sch, CPU_RESET_BUFFERS.kicad_sch, Reset, CPU and Buffers.kicad_sch, ResetCPU.kicad_sch]
2025-09-13 Added Arduino Mega to test the circuit. Will be useful for testing the PLDs later
    [CPU_RESET_BUFFERS.kicad_sch, Reset, CPU and Buffers.kicad_sch]
2025-09-24 Added resistor to MIC1232
    [CPU_RESET_BUFFERS.kicad_sch, Reset, CPU and Buffers.kicad_sch]
2025-09-25 First commit for episode 3
    [CPU_RESET_BUFFERS.kicad_sch, PLD.kicad_sch, PLDs.kicad_pcb, PLDs.kicad_sch]
2025-09-25 Updated paths
    [NOP testing the HD63C09.kicad_sch, Reset, CPU and Buffers.kicad_sch]
2025-09-25 Updating PLD pin assignments
    [PLD.kicad_sch, PLDs.kicad_sch]
2025-11-16 Pushing back everything, due to PC reinstall.
    [CPU_RESET_BUFFERS.kicad_sch, Clock.kicad_sch, Glue Logic.kicad_pcb, Glue Logic.kicad_sch, Glue.kicad_sch, NOP testing the HD63C09.kicad_pcb, NOP testing the HD63C09.kicad_sch, PLD.kicad_sch]
2025-11-16 Tied up a few loose ends in the PLD page.
    [CPU_RESET_BUFFERS.kicad_sch, Glue Logic.kicad_sch, Glue.kicad_sch, OscillatorVSclock.xls]
2025-11-17 Corrected OE error
    [Glue.kicad_sch]
2025-11-24 Major updates to PLDs
    [CPU_RESET_BUFFERS.kicad_sch, Glue.kicad_sch]
2025-11-28 Reduced PLDs from 5 to 4, and optimized macrocells to the maximum
    [CPU_RESET_BUFFERS.kicad_sch, Glue Logic.kicad_sch, Glue.kicad_sch]
2025-11-28 Corrected minor changes in PLDs to reflect Schematic
2025-11-30 Exploited every last macrocells I could.
    [CPU_RESET_BUFFERS.kicad_sch, Glue Logic.kicad_sch, Glue.kicad_sch]
2025-12-03 Swapped E and IORQ pin on IOdecode
    [Glue.kicad_sch]
2025-12-04 Issues with PLDs, attempting a workaround
    [CPU_RESET_BUFFERS.kicad_sch, Clock.kicad_sch, Glue Logic v2.kicad_pcb, Glue Logic v2.kicad_sch, Glue.kicad_sch]
2025-12-10 changed strategy and simplified things
    [CPU_RESET_BUFFERS.kicad_sch, Glue Logic v2.kicad_sch, Glue.kicad_sch]
2026-02-07 Massive changes to the PLD code (tested) - Minor changes to the Schematic
    [CPU_RESET_BUFFERS.kicad_sch, Clock.kicad_sch, Glue Logic v2.kicad_pcb, Glue Logic v2.kicad_sch, Glue Logic.kicad_pcb, Glue Logic.kicad_sch, Glue.kicad_sch, NOP testing the HD63C09.kicad_pcb]
2026-02-07 Preparing the next show, ROM and RAM
    [CPU_RESET_BUFFERS.kicad_sch, Glue.kicad_sch, Memory.kicad_sch, ROMRAM.kicad_sch]
2026-02-16 Project Update, change in strategy from breadboard to PCB
    [CPU_RESET_BUFFERS.kicad_sch, Episode4.kicad_pcb, Episode4.kicad_sch, Glue.kicad_sch, ROMRAM.kicad_sch, ResetCircuit.kicad_sch, ShadowLockCircuit.circ, SoftPower.kicad_sch]
2026-02-16 Added traces to the backplane manually.
    [Episode4.kicad_pcb, Episode4.kicad_sch]
2026-02-17 Added more capacitors and extended the bus form 7 to 12
    [Caps.kicad_sch, Episode4.kicad_pcb, Episode4.kicad_sch, SoftPower.kicad_sch]
2026-02-17 Worked on BOM
    [Caps.kicad_sch, Episode4.kicad_pcb, Episode4.kicad_sch, SoftPower.kicad_sch]
2026-02-18 Changed bus from 62 to 72 pins
    [Caps.kicad_sch, Episode4.kicad_pcb, Episode4.kicad_sch, SoftPower.kicad_sch]
2026-02-18 Placed bus traces
    [Episode4.kicad_pcb]
2026-02-19 Added various IRQ and FIRQ lines
    [Episode4.kicad_pcb, Episode4.kicad_sch]
2026-02-19 Shuffled around IRQ numbers, and removed NMI, as it will by on the CPU card only.
    [Episode4.kicad_pcb, Episode4.kicad_sch]
2026-02-20 Changed data trace width, and moving power lanes to inner power plane.
    [Episode4.kicad_pcb]
2026-02-20 Reworked bus line order, capacitor and trace placement
    [Caps.kicad_sch, Episode4.kicad_pcb, Episode4.kicad_sch]
2026-02-23 Added some KiCad parts to the library
2026-02-23 Finished the backplane
    [Caps.kicad_sch, Episode4.kicad_sch]
2026-02-23 Moved power traces from inner CU to back CU
    [Caps.kicad_sch, Episode4.kicad_sch, ResetCircuit.kicad_sch, SoftPower.kicad_sch]
2026-02-23 CPU card initial commit
    [CPU_RESET_BUFFERS.kicad_sch, Episode5.kicad_pcb, Episode5.kicad_sch, Glue.kicad_sch, ROMRAM.kicad_sch]
2026-02-25 Placed Global labels instead. And toying with new PLDs
    [CPU_RESET_BUFFERS.kicad_sch, Episode5.kicad_sch, Glue.kicad_sch, ROMRAM.kicad_sch]
2026-02-26 Toying with different alternatives for the CPU board
    [CPU_RESET_BUFFERS.kicad_sch, Episode5.kicad_sch, Glue.kicad_sch, ROMRAM.kicad_sch]
2026-02-28 Finished the preliminary design of the CPU card
    [ACIA.kicad_sch, Blinkenlights.kicad_sch, CLock.kicad_sch, CPU_RESET_BUFFERS.kicad_sch, Episode5.kicad_sch, Glue.kicad_sch, Interrupts.kicad_sch, ROMRAM.kicad_sch]
2026-02-28 Segmenting Core functionality into multiple cards.
    [ACIA.kicad_sch, Blinkenlights.kicad_sch, CLock.kicad_sch, CPU_RESET_BUFFERS.kicad_sch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]
2026-03-01 Toyed with CPU PCB
    [CPU_RESET_BUFFERS.kicad_sch, Episode5 - CPU card.kicad_pcb, Episode5 - CPU card.kicad_sch, ROMRAM.kicad_sch]
